mvanhorn/opentac/opentac/cad/web/example-thumbnails/allegro_palm.png

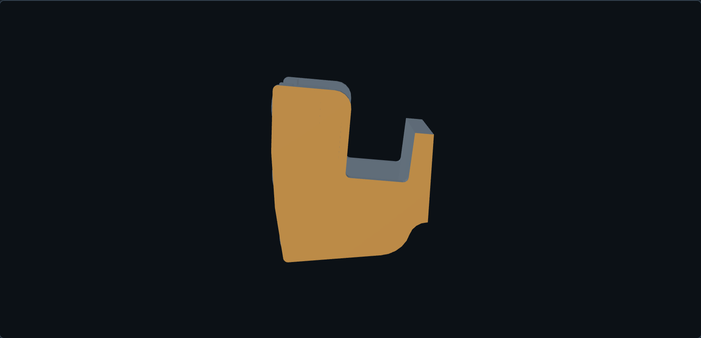
opentac/cad/web/example-thumbnails/allegro_palm.png
