mvanhorn/opentac/opentac/cad/web/example-thumbnails/FINGER_PAD_t30_L.png

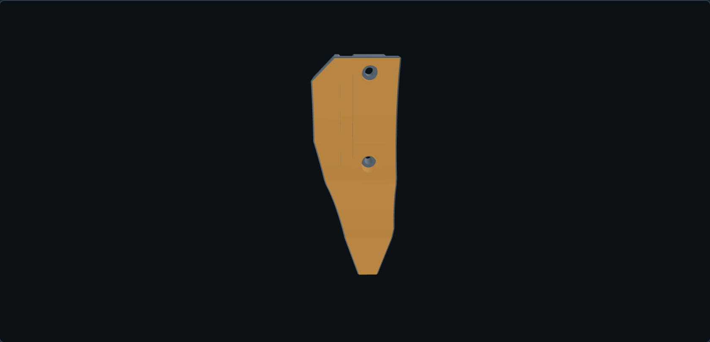
opentac/cad/web/example-thumbnails/FINGER_PAD_t30_L.png
