mvanhorn/opentac/opentac/cad/web/example-thumbnails/franka_fingertip.png

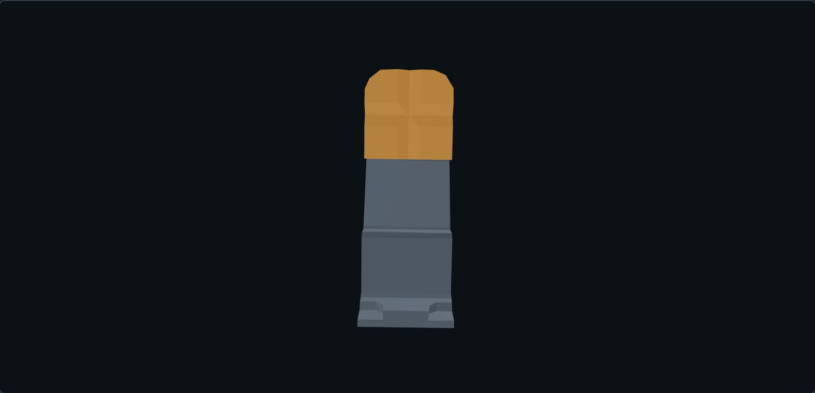
opentac/cad/web/example-thumbnails/franka_fingertip.png
