mvanhorn/opentac/opentac/cad/web/example-thumbnails/leap_hand_fingertip.png

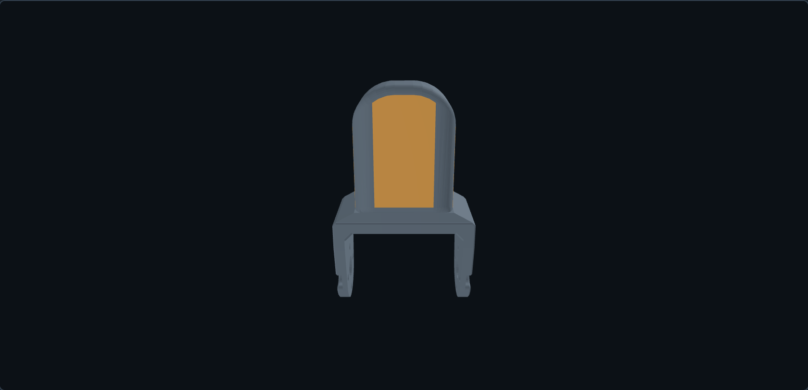
opentac/cad/web/example-thumbnails/leap_hand_fingertip.png
