mvanhorn/opentac/opentac/cad/web/example-thumbnails/so101_fixed_jaw_wrist_roll.png

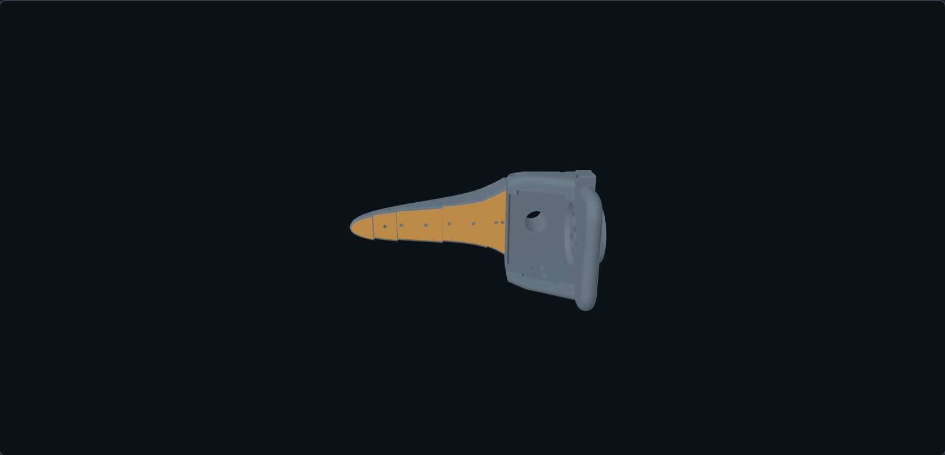
opentac/cad/web/example-thumbnails/so101_fixed_jaw_wrist_roll.png
