mvanhorn/opentac/opentac/cad/web/example-thumbnails/so101_moving_jaw.png

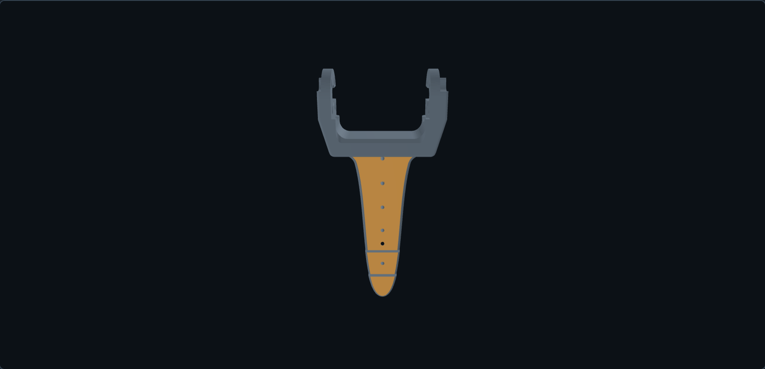
opentac/cad/web/example-thumbnails/so101_moving_jaw.png
