mvanhorn/opentac/opentac/cad/web/example-thumbnails/umi_soft_gripper_finger.png

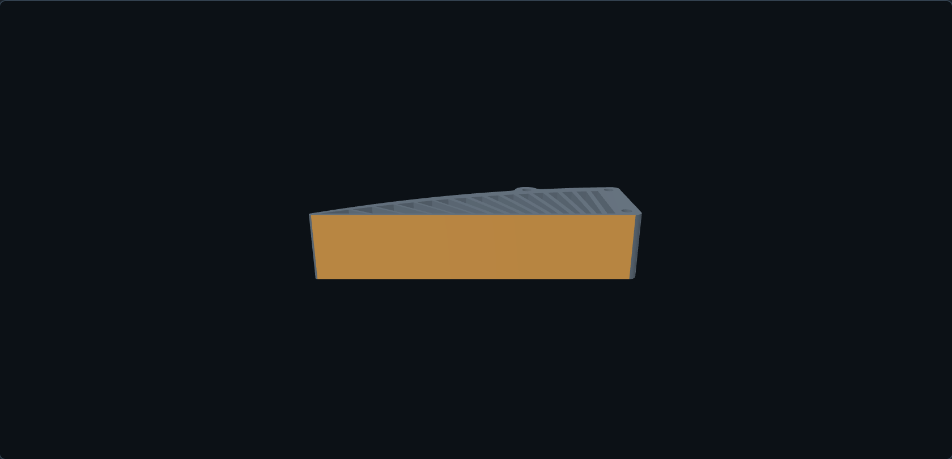
opentac/cad/web/example-thumbnails/umi_soft_gripper_finger.png
