mvanhorn/opentac/hardware/readout_30pin/top/bom.csv

Designator | Footprint | Quantity | Value | LCSC Part # | MPN
C16, C2, C3, C31, C32 | 0201 | 5 | 0.1u | C49062 | CL03A104KP3NNNC
C28, C38, C39 | 0402 | 3 | 10u | C15525 | CL05A106MQ5NUNC
CN1, CN2 | C160390_CONN-SMD_BM04B-SRSS-TB | 2 | BM04B-SRSS-TB(LF)(SN) | C160390 | BM04B-SRSS-TB(LF)(SN)
D1, D3 | C191023_SOD-323_L1_8-W1_3-LS2_5-RD | 2 | 1N5819WS | C191023 | 1N5819WS
IC3 | QFN50P500X500X60-33N-D | 1 | STM32G431KBU6 | C529358 | STM32G431KBU6
IC5 | LSM6DSV16BXTR | 1 | LSM6DSV16BXTR | C5267394 | LSM6DSV16BXTR
J1, J3 | PinHeader_1x07_P1.27mm_Vertical_SMD_Pin1Left | 2 | Conn_01x07_Pin | C55590761 | PZ1.27-1x7PLT-L7.2-R
LED1 | C5349955_LED-SMD_4P-L2_0-W2_0-BR-1 | 1 | XL-2020RGBC-WS2812B | C5349955 | XL-2020RGBC-2812B
R18 | 0201 | 1 | 100k | C106224 | RC0201FR-07100KL
R19, R20 | 0201 | 2 | 4.7k | C138135 | RC0201FR-074K7L
R4 | 0201 | 1 | 10k | C106225 | RC0201FR-0710KL
S4 | SW_TS-1088-AR02016 | 1 | TS-1088-AR02016 | C720477 | TS-1088-AR02016
U1 | SOT-23-5 | 1 | TLV75533PDBV | C404027 | TLV75533PDBVR
USB2 | C2681556_MICRO-USB-SMD_MICRO-QTZB5_0 | 1 | MICRO QTZB5.0 | C2681556 | MICRO QTZB5.0
