mvanhorn/opentac/hardware/readout_30pin/bottom/bom.csv

Designator | Footprint | Quantity | Value | LCSC Part # | MPN
C10, C12, C14, C15, C9 | 0402 | 5 | 0.1u | C1525 | CL05B104KO5NNNC
C34, C35 | 0402 | 2 | 1u | C52923 | CL05A105KA5NQNC
C36 | 0402 | 1 | 10u | C15525 | CL05A106MQ5NUNC
IC1 | SOT65P280X110-8N | 1 | TLV9362IDDFR | C5119287 | TLV9362IDDFR
IC2 | SOP65P638X110-28N | 1 | ADG706BRUZ | C579088 | ADG706BRUZ
IC8, IC9 | NVT2006BQ115 | 2 | 74HC595BQ | C730243 | 74HC595BQ
J2, J3 | PinSocket_1x07_P1.27mm_Vertical_SMD_Pin1Right | 2 | Conn_01x07_Pin | C55218864 | PM1.27-1x7PLT-H4.3-R
J4 | CON_5051103091_MOL | 1 | Conn_01x30_Pin | C588008 | 5051103091
R5, R6, R7 | 0402 | 3 | 1k | C11702 | 0402WGF1001TCE
U7 | SOT-23-6 | 1 | LM2776 | C69527 | LM2776DBVR
