mvanhorn/opentac/hardware/readout_60pin/production/stm-i2c-60-switch_bom.csv

Designator | Footprint | Quantity | Value | LCSC Part #
C1, C10, C13, C14, C15, C17, C60, C9 | 0402 | 8 | 0.1u | C1525
C16, C2, C3, C31, C32 | 0201 | 5 | 0.1u | C49062
C28, C36, C38, C39 | 0402 | 4 | 10u | C15525
C34, C35 | 0402 | 2 | 1u | C52923
C52 | 0402 | 1 | 47p | C1567
C54 | 0402 | 1 | 100p | C1546
C55 | 0402 | 1 | 470p | C106259
C57 | 0402 | 1 | 1.8n | C385028
C59 | 0402 | 1 | 6.8n | C1518206
CN1, CN2 | C160390_CONN-SMD_BM04B-SRSS-TB | 2 | BM04B-SRSS-TB(LF)(SN) | C160390
D1, D3 | C191023_SOD-323_L1_8-W1_3-LS2_5-RD | 2 | 1N5819WS | C191023
IC1 | SOT65P280X110-8N | 1 | TLV9362IDDFR | C5119287
IC11, IC12, IC8, IC9 | NVT2006BQ115 | 4 | 74HC595BQ | C730243
IC3 | QFN50P500X500X60-33N-D | 1 | STM32G431KBU6 | C529358
IC4 | QFP50P900X900X120-48N | 1 | ADG732BSUZ | C114845
IC5 | LSM6DSV16BXTR | 1 | LSM6DSV16BXTR | C5267394
J4 | C493444_FPC-SMD_5051106091 | 1 | 5051106091 | C493444
LED1 | C5349955_LED-SMD_4P-L2_0-W2_0-BR-1 | 1 | XL-2020RGBC-WS2812B | C5349955
R18 | 0201 | 1 | 100k | C106224
R19, R20 | 0201 | 2 | 4.7k | C138135
R21 | 0402 | 1 | 10k | C25744
R23 | 0402 | 1 | 4.7k | C25900
R24 | 0402 | 1 | 1.1k | C25860
R26 | 0402 | 1 | 270 | C25099
R28 | 0402 | 1 | 68 | C25131
R4 | 0201 | 1 | 10k | C106225
R6, R7 | 0402 | 2 | 1k | C11702
S4 | SW_TS-1088-AR02016 | 1 | TS-1088-AR02016 | C720477
U1 | SOT-23-5 | 1 | TLV75533PDBV | C404027
U10 | C2673377_TQFN-28_L4_0-W4_0-P0_40-BL-EP | 1 | MAX14662ETI+T | C2673377
U7 | SOT-23-6 | 1 | LM2776 | C69527
USB2 | C404969_MICRO-USB-SMD_MICROXNJ_1 | 1 | MicroXNJ | C404969
