mvanhorn/opentac/examples/stl/end_effectors/agilex_piper/gripper_base.stl

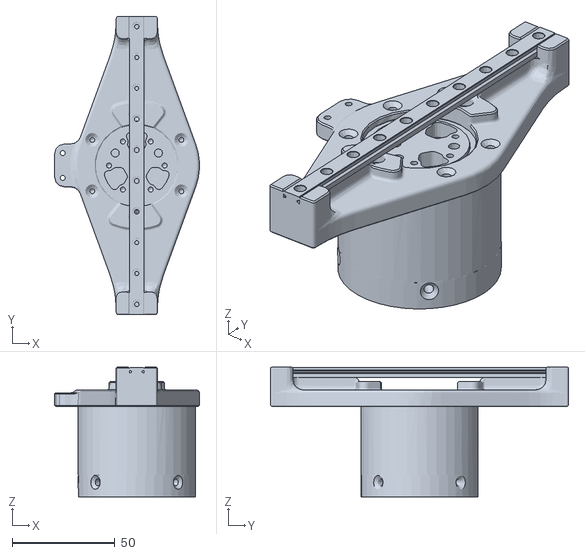
[picture p9: CAD file, 2026-10-15]
examples/stl/end_effectors/agilex_piper/gripper_base.stl
70.5 x 145.0 x 63.0
