mvanhorn/opentac/examples/stl/end_effectors/allegro/thumb_fingertip.stl

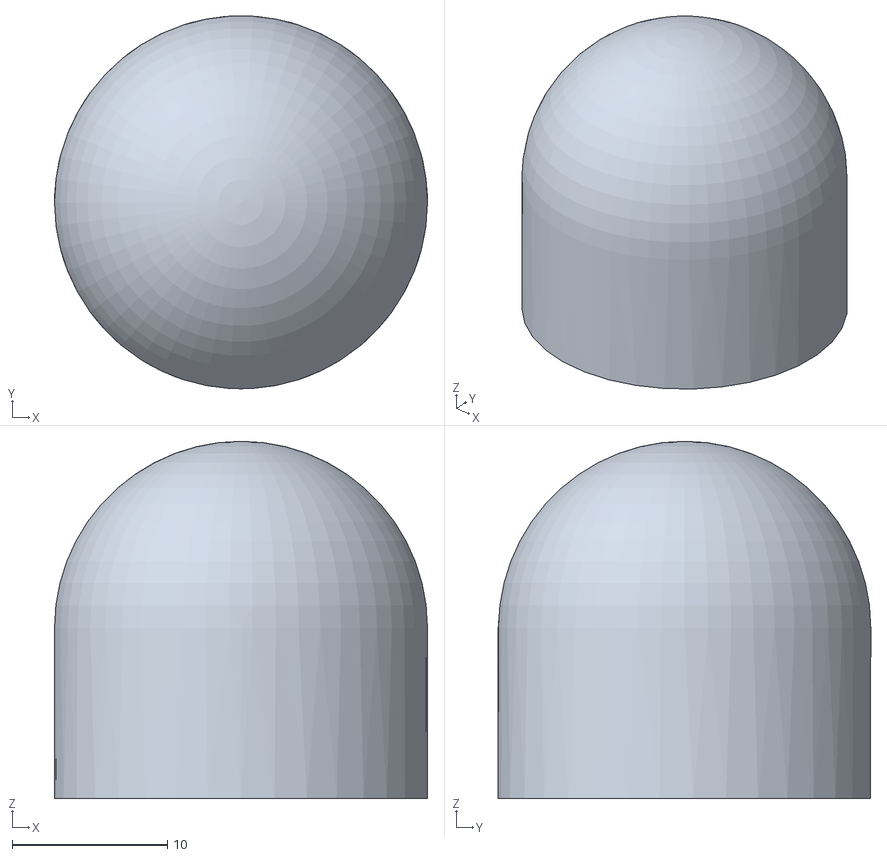
[picture p10: CAD file, 2026-10-15]
examples/stl/end_effectors/allegro/thumb_fingertip.stl
24.0 x 24.0 x 23.0
