mvanhorn/opentac/examples/stl/end_effectors/aloha_vx300s/gripper_finger.stl

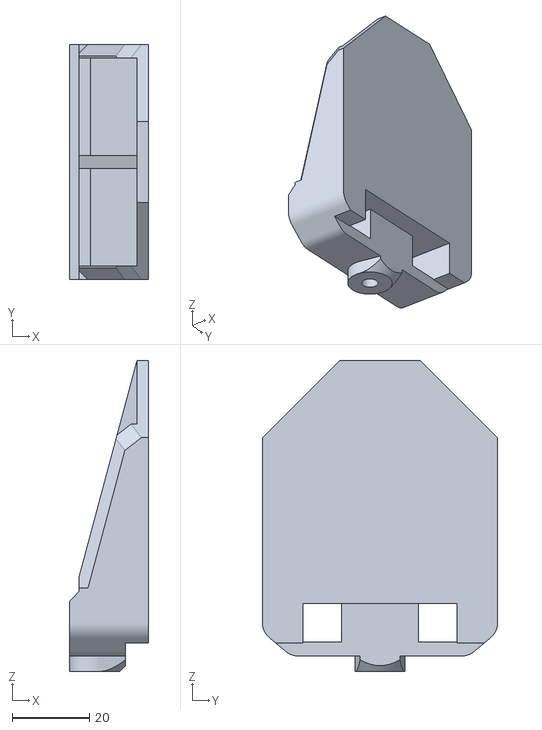
[picture p11: CAD file, 2026-10-15]
examples/stl/end_effectors/aloha_vx300s/gripper_finger.stl
20.5 x 61.0 x 80.6
