mvanhorn/opentac/examples/stl/end_effectors/dclaw/fingertip_4.stl

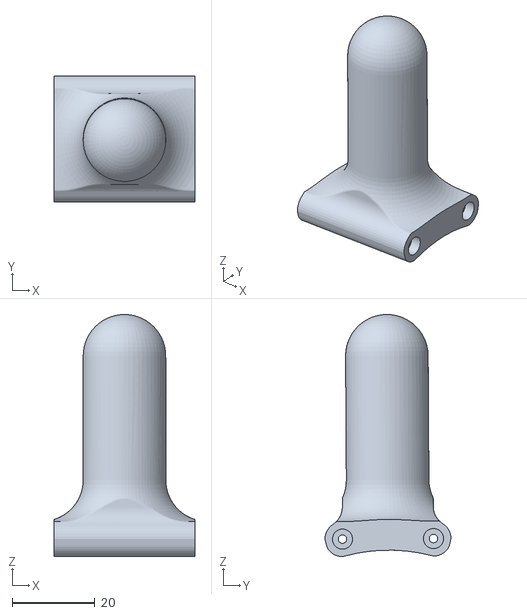
[picture p12: CAD file, 2026-10-15]
examples/stl/end_effectors/dclaw/fingertip_4.stl
34.0 x 30.5 x 58.5
