mvanhorn/opentac/examples/stl/end_effectors/franka/arm_link5.stl

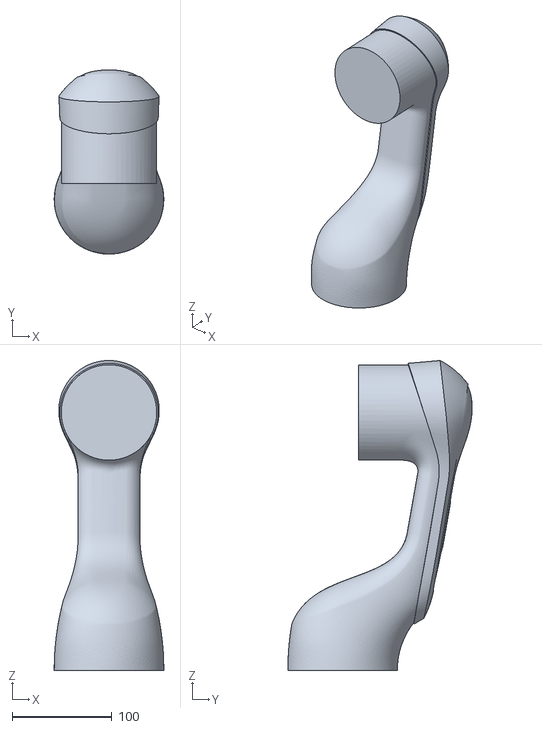
[picture p13: CAD file, 2026-10-15]
examples/stl/end_effectors/franka/arm_link5.stl
110.0 x 184.9 x 311.2
