mvanhorn/opentac/examples/stl/end_effectors/inspire_hand/palm.stl

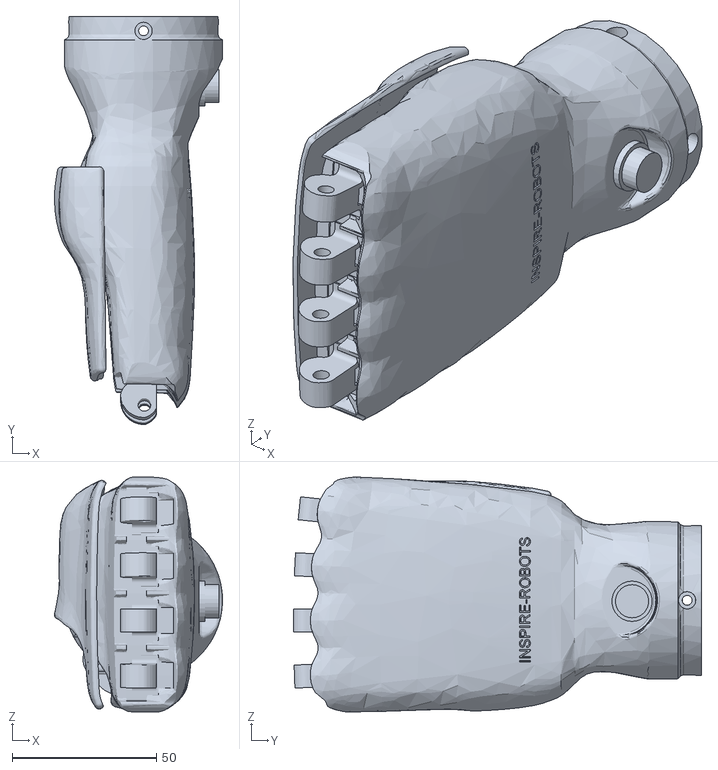
[picture p14: CAD file, 2026-10-15]
examples/stl/end_effectors/inspire_hand/palm.stl
58.3 x 141.5 x 81.5
