mvanhorn/opentac/examples/stl/end_effectors/leap_hand/palm.stl

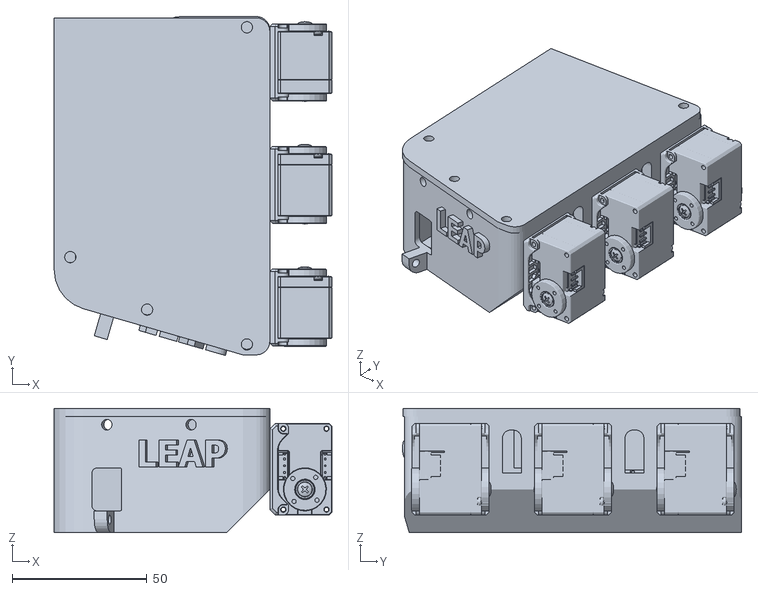
[picture p15: CAD file, 2026-10-15]
examples/stl/end_effectors/leap_hand/palm.stl
103.0 x 125.7 x 46.0
