mvanhorn/opentac/examples/stl/end_effectors/onrobot_rg2/inner_finger.stl

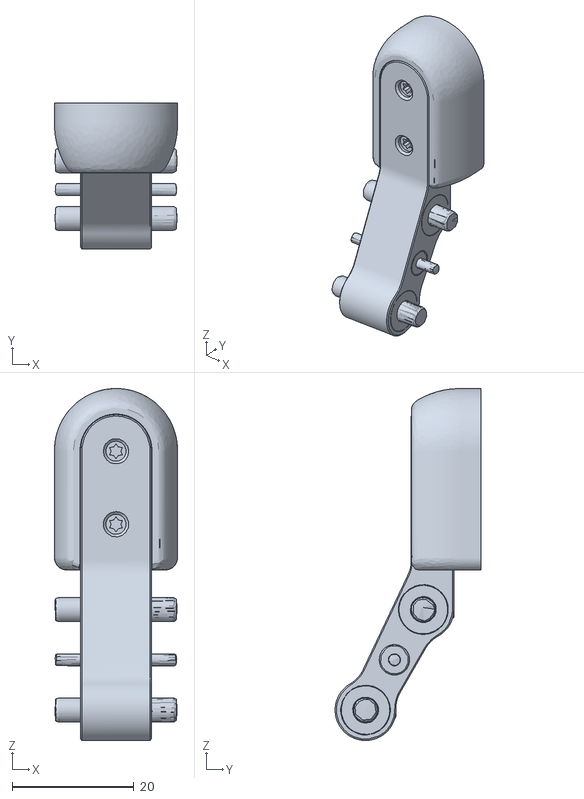
[picture p16: CAD file, 2026-10-15]
examples/stl/end_effectors/onrobot_rg2/inner_finger.stl
20.2 x 23.9 x 57.8
