mvanhorn/opentac/examples/stl/end_effectors/onrobot_vg10/suction_cups.stl

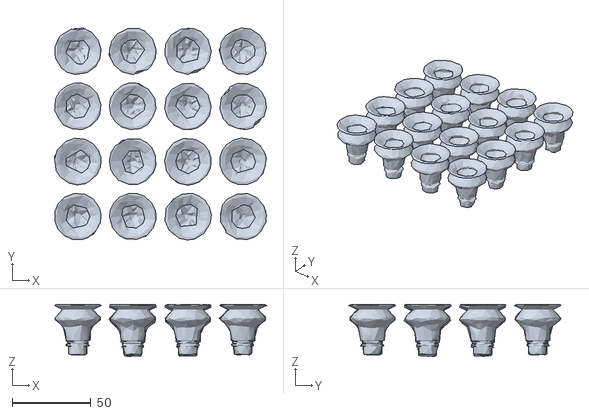
[picture p17: CAD file, 2026-10-15]
examples/stl/end_effectors/onrobot_vg10/suction_cups.stl
134.7 x 134.7 x 33.1
