mvanhorn/opentac/examples/stl/end_effectors/orca_hand/palm.stl

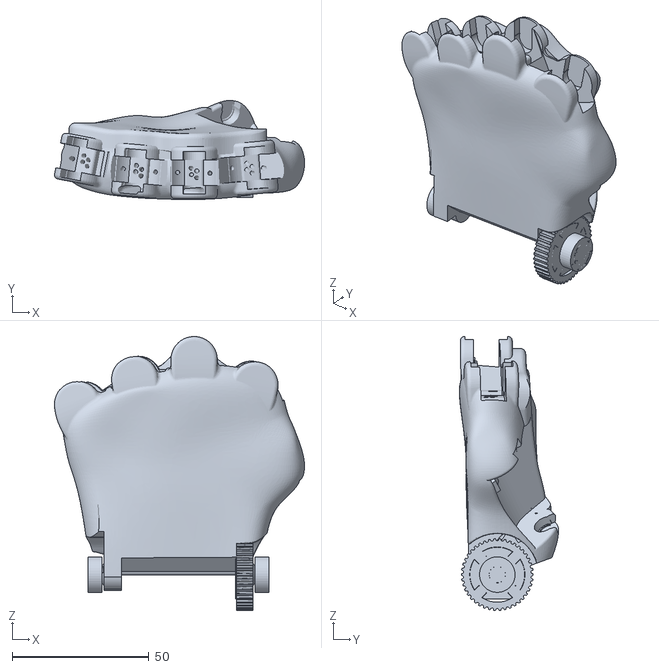
[picture p18: CAD file, 2026-10-15]
examples/stl/end_effectors/orca_hand/palm.stl
91.4 x 36.3 x 100.1
