mvanhorn/opentac/examples/stl/end_effectors/robotiq_2f140/inner_finger.stl

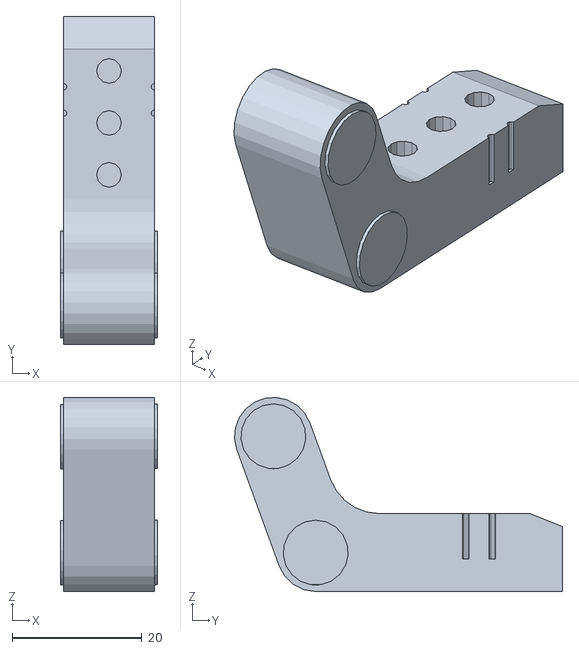
[picture p19: CAD file, 2026-10-15]
examples/stl/end_effectors/robotiq_2f140/inner_finger.stl
15.0 x 50.5 x 29.9
