mvanhorn/opentac/examples/stl/end_effectors/schunk_sdh/finger.stl

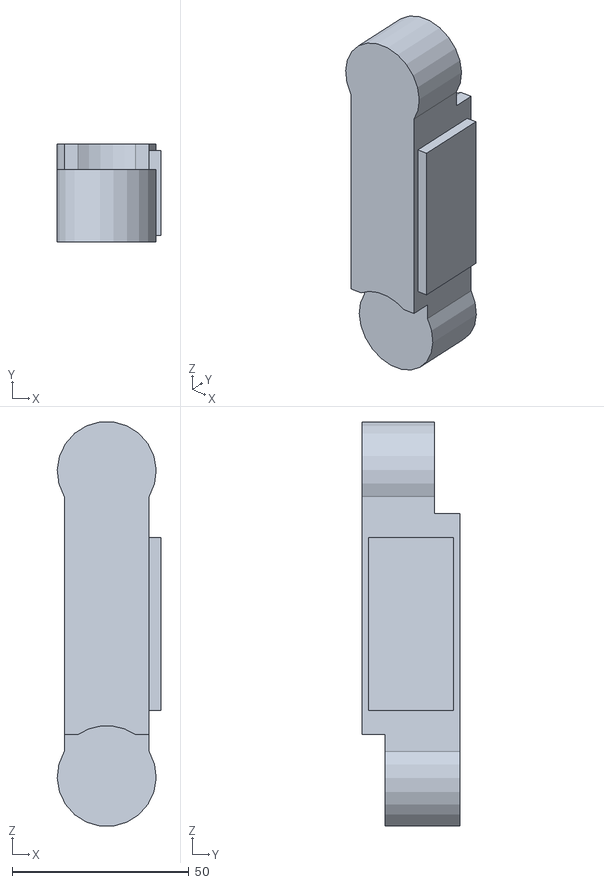
[picture p20: CAD file, 2026-10-15]
examples/stl/end_effectors/schunk_sdh/finger.stl
29.3 x 27.8 x 114.2
