mvanhorn/opentac/examples/stl/end_effectors/so101/fixed_jaw_wrist_roll.stl

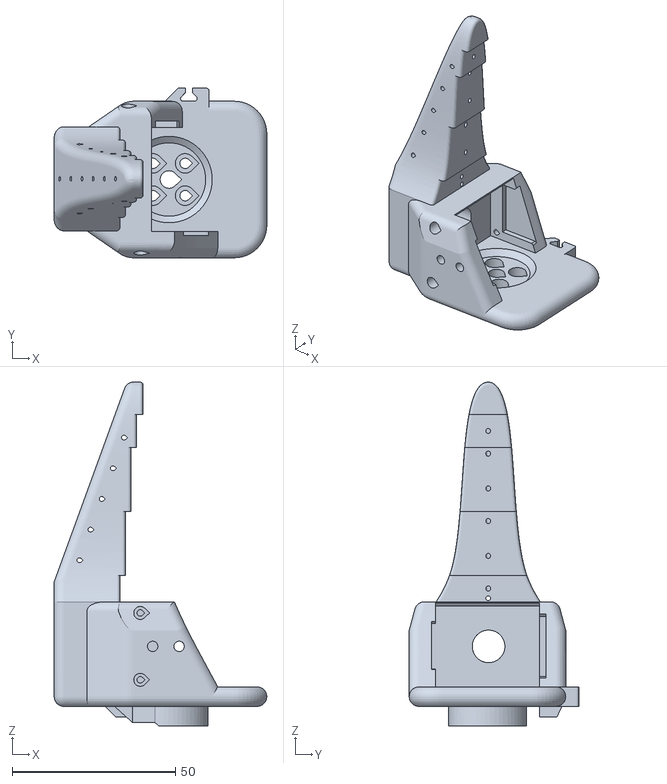
[picture p21: CAD file, 2026-10-15]
examples/stl/end_effectors/so101/fixed_jaw_wrist_roll.stl
65.2 x 52.0 x 105.4
