mvanhorn/opentac/examples/stl/end_effectors/umi/jaw_right.stl

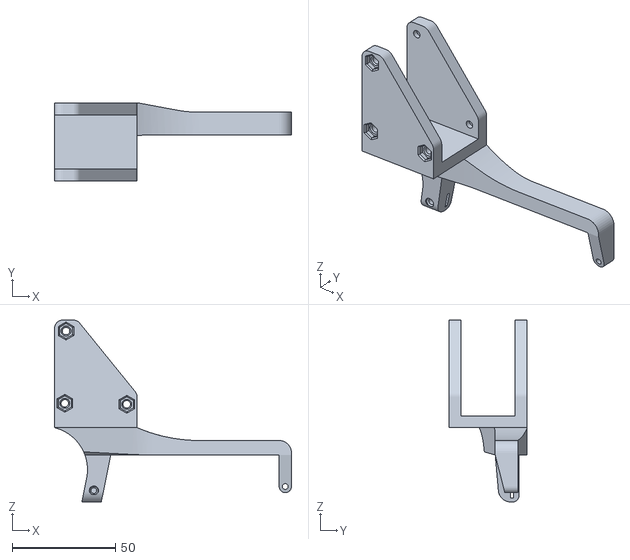
[picture p22: CAD file, 2026-10-15]
examples/stl/end_effectors/umi/jaw_right.stl
114.8 x 38.0 x 88.1
