mvanhorn/opentac/examples/stl/end_effectors/unitree_b2/foot.stl

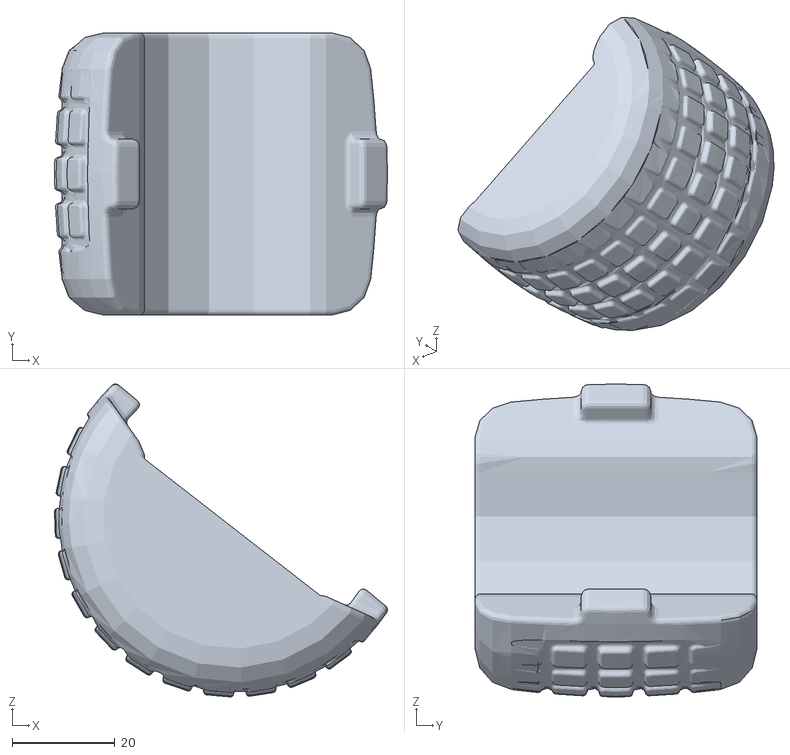
[picture p23: CAD file, 2026-10-15]
examples/stl/end_effectors/unitree_b2/foot.stl
64.9 x 55.0 x 61.0
