mvanhorn/opentac/examples/stl/end_effectors/unitree_dex3/palm.stl

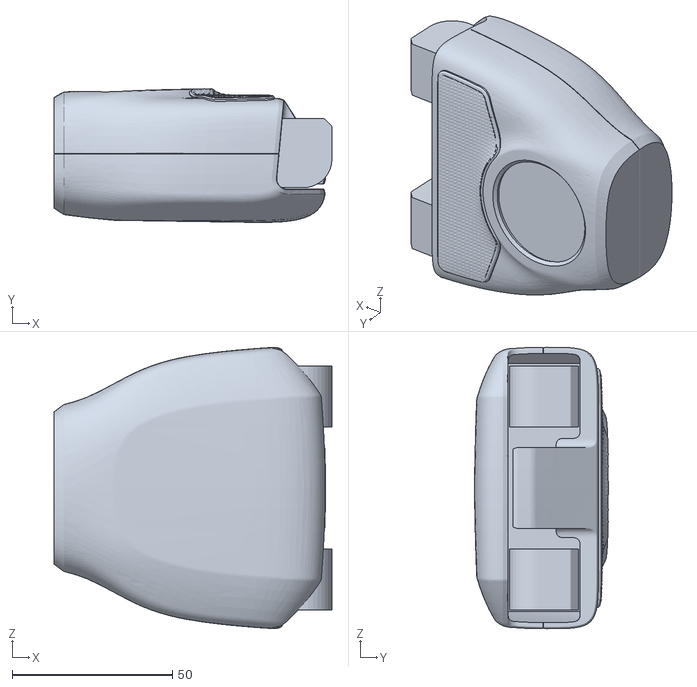
[picture p24: CAD file, 2026-10-15]
examples/stl/end_effectors/unitree_dex3/palm.stl
86.7 x 41.7 x 87.8
