mvanhorn/opentac/examples/stl/end_effectors/unitree_go2/calf.stl

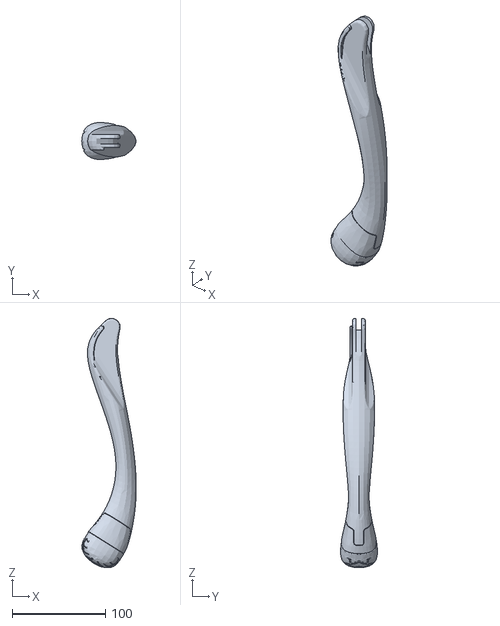
[picture p25: CAD file, 2026-10-15]
examples/stl/end_effectors/unitree_go2/calf.stl
58.4 x 39.6 x 266.7
