mvanhorn/opentac/examples/stl/end_effectors/xarm_gripper/lite_finger.stl

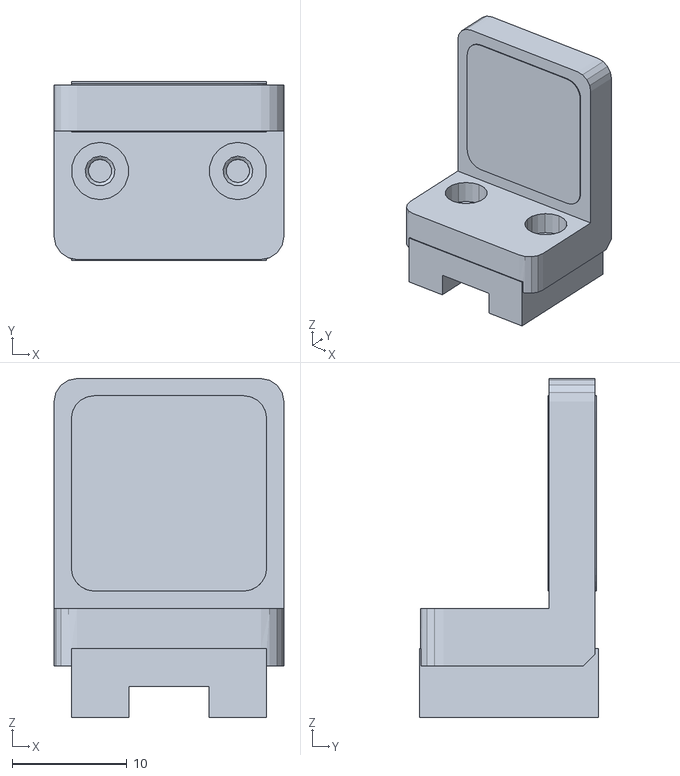
[picture p26: CAD file, 2026-10-15]
examples/stl/end_effectors/xarm_gripper/lite_finger.stl
20.0 x 15.6 x 29.5
