mvanhorn/opentac/examples/stl/end_effectors/yale_openhand/model_o_proximal.stl

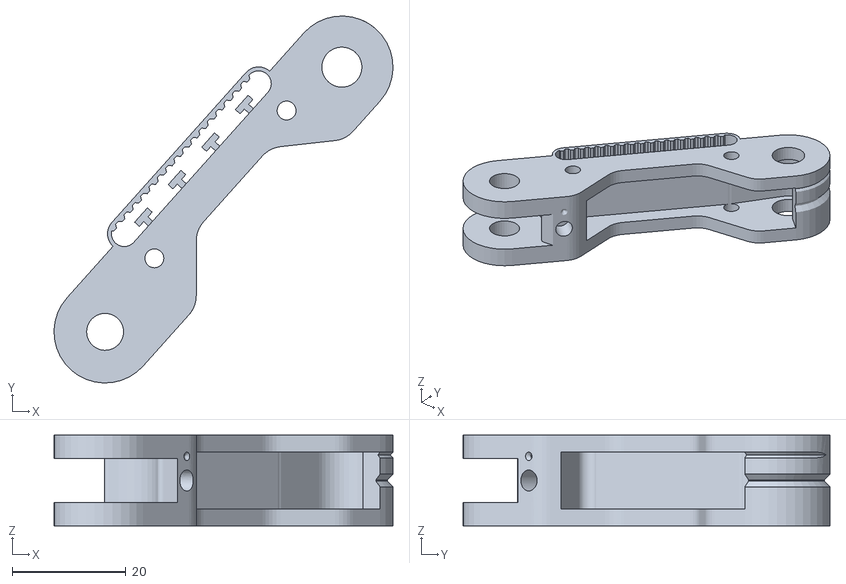
[picture p27: CAD file, 2026-10-15]
examples/stl/end_effectors/yale_openhand/model_o_proximal.stl
59.7 x 64.6 x 16.0
