mvanhorn/opentac/examples/stl/FINGER PAD_t30_L.stl

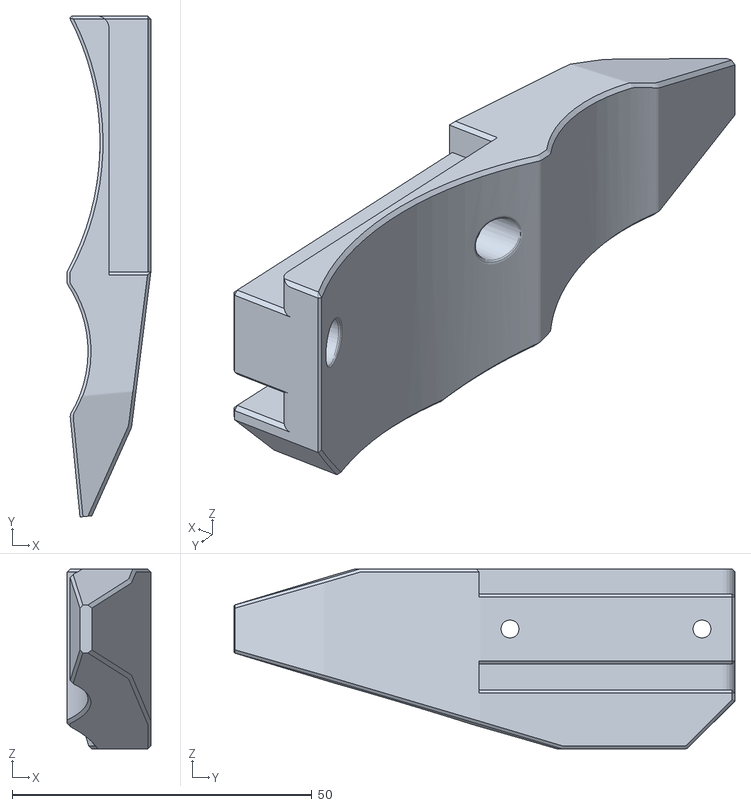
[picture p28: CAD file, 2026-10-15]
examples/stl/FINGER PAD_t30_L.stl
14.0 x 83.5 x 30.0
