mvanhorn/opentac/opentac/cad/web/example-meshes/inspire_hand_thumb_distal.stl

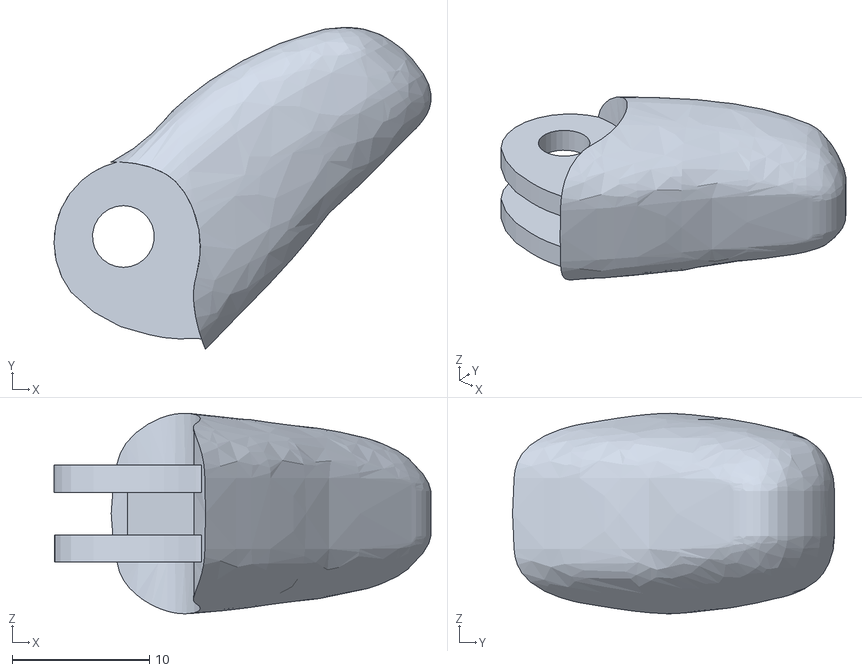
[picture p29: CAD file, 2026-10-15]
opentac/cad/web/example-meshes/inspire_hand_thumb_distal.stl
27.5 x 23.5 x 14.6
