mvanhorn/opentac/examples/stl/end_effectors/agilex_piper/jaw_link7.stl

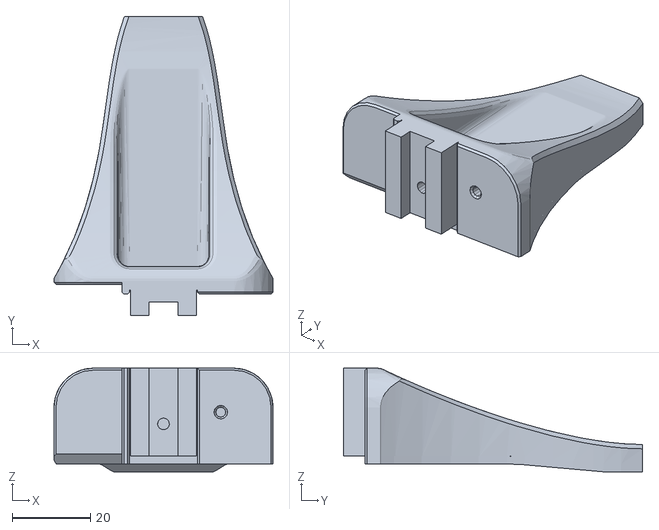
[picture p30: CAD file, 2026-10-15]
examples/stl/end_effectors/agilex_piper/jaw_link7.stl
56.0 x 76.5 x 26.5
