mvanhorn/opentac/examples/stl/end_effectors/dclaw/fingertip.stl

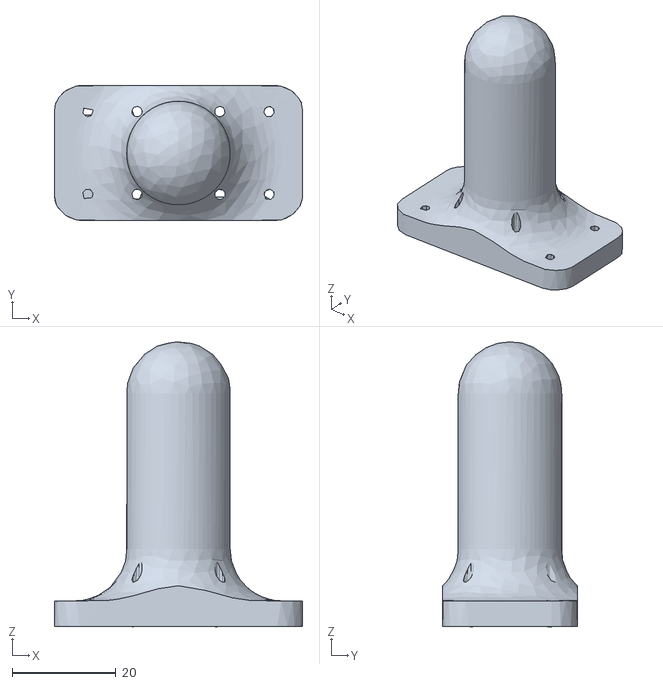
[picture p31: CAD file, 2026-10-15]
examples/stl/end_effectors/dclaw/fingertip.stl
48.0 x 26.0 x 55.1
