mvanhorn/opentac/examples/stl/end_effectors/franka/fingertip.stl

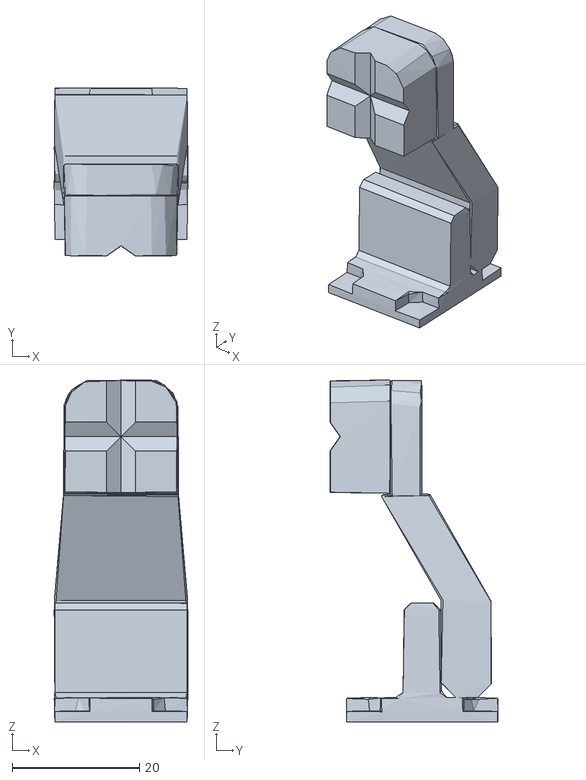
[picture p32: CAD file, 2026-10-15]
examples/stl/end_effectors/franka/fingertip.stl
21.0 x 26.4 x 53.8
