mvanhorn/opentac/examples/stl/end_effectors/inspire_hand/index_fingertip.stl

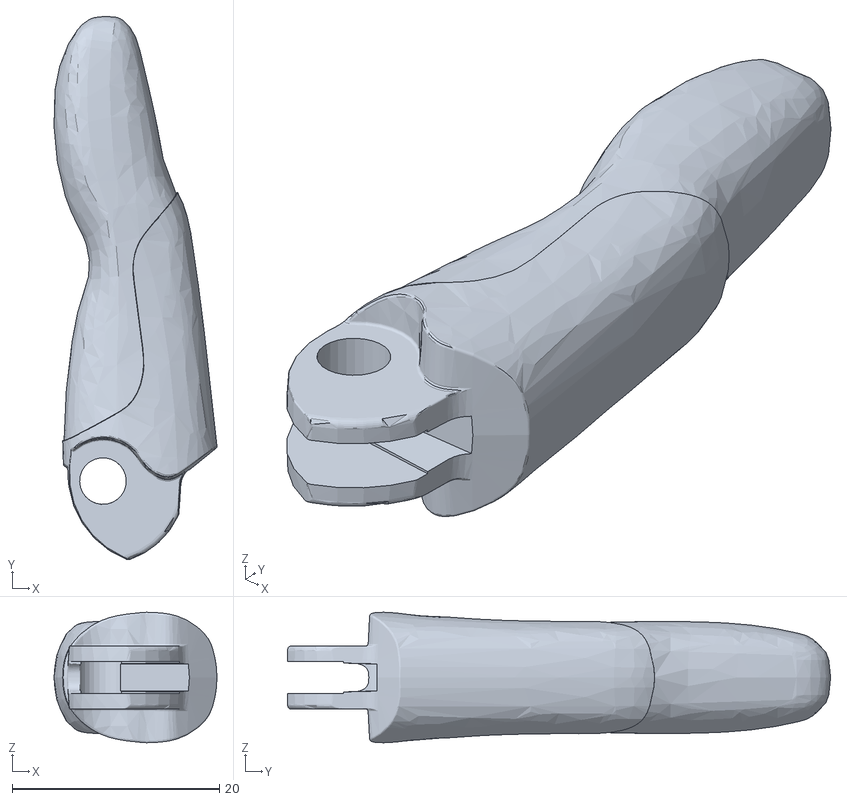
[picture p33: CAD file, 2026-10-15]
examples/stl/end_effectors/inspire_hand/index_fingertip.stl
15.7 x 52.5 x 12.6
