mvanhorn/opentac/examples/stl/end_effectors/leap_hand/thumb_fingertip.stl

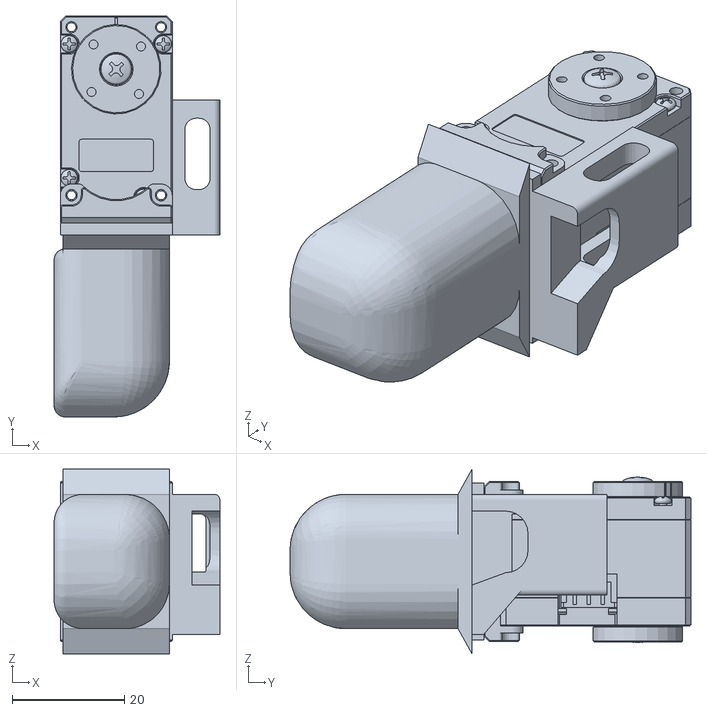
[picture p34: CAD file, 2026-10-15]
examples/stl/end_effectors/leap_hand/thumb_fingertip.stl
29.6 x 71.6 x 33.0
