mvanhorn/opentac/examples/stl/end_effectors/onrobot_vg10/base.stl

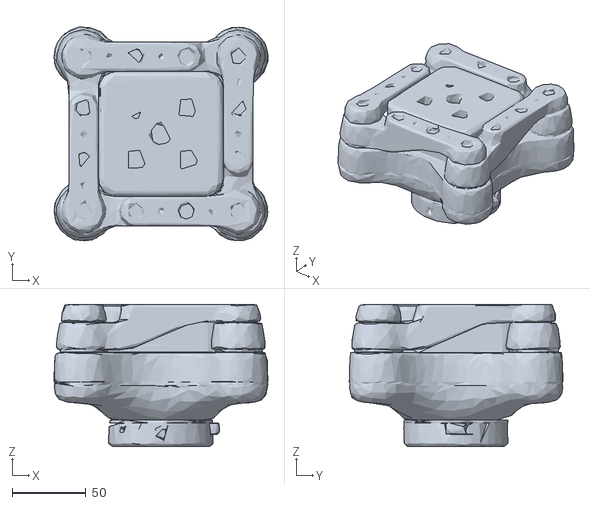
[picture p35: CAD file, 2026-10-15]
examples/stl/end_effectors/onrobot_vg10/base.stl
145.4 x 145.2 x 96.7
