mvanhorn/opentac/examples/stl/end_effectors/orca_hand/fingertip.stl

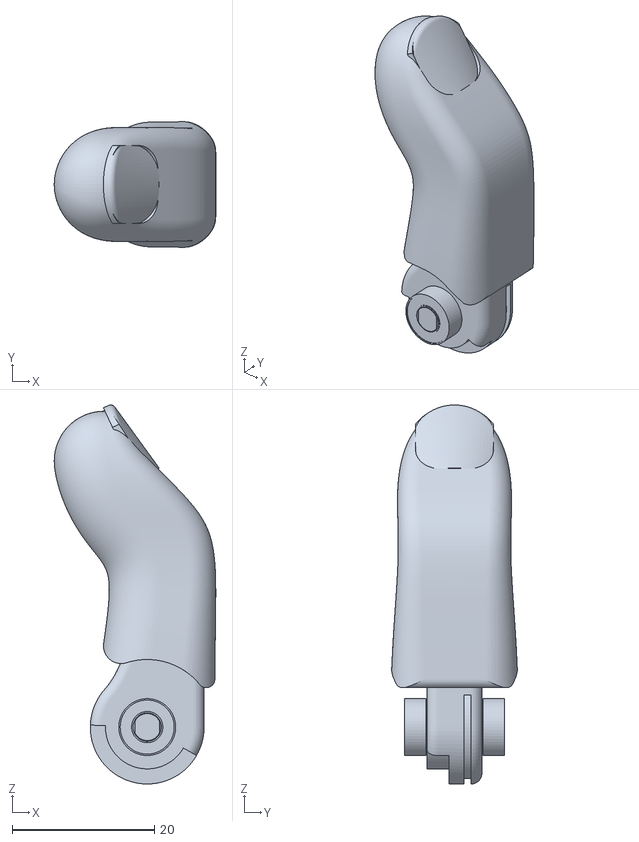
[picture p36: CAD file, 2026-10-15]
examples/stl/end_effectors/orca_hand/fingertip.stl
22.7 x 17.7 x 53.3
