mvanhorn/opentac/examples/stl/end_effectors/schunk_sdh/finger_tip.stl

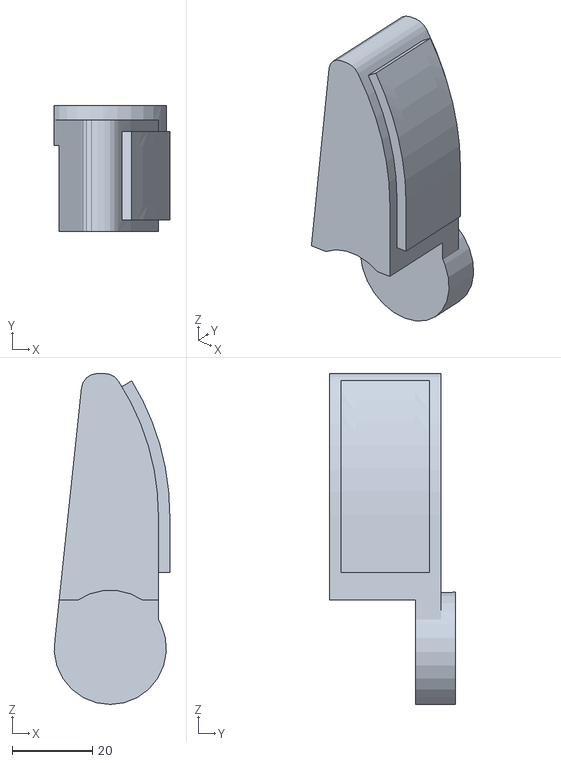
[picture p37: CAD file, 2026-10-15]
examples/stl/end_effectors/schunk_sdh/finger_tip.stl
28.8 x 31.3 x 82.5
