mvanhorn/opentac/examples/stl/end_effectors/so101/moving_jaw.stl

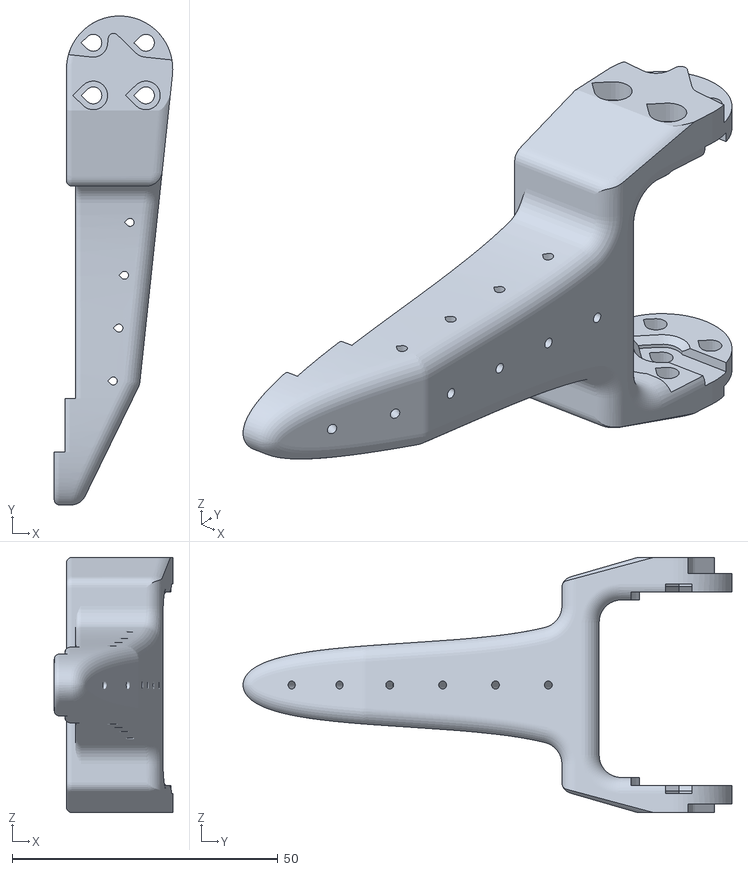
[picture p38: CAD file, 2026-10-15]
examples/stl/end_effectors/so101/moving_jaw.stl
22.3 x 92.0 x 48.0
