mvanhorn/opentac/examples/stl/end_effectors/unitree_dex3/thumb_distal.stl

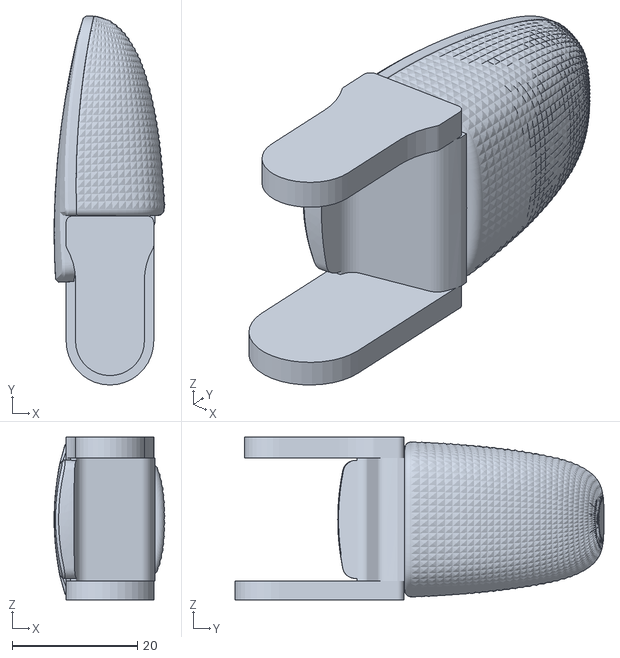
[picture p39: CAD file, 2026-10-15]
examples/stl/end_effectors/unitree_dex3/thumb_distal.stl
17.7 x 59.0 x 26.0
