mvanhorn/opentac/examples/stl/end_effectors/unitree_go2/foot.stl

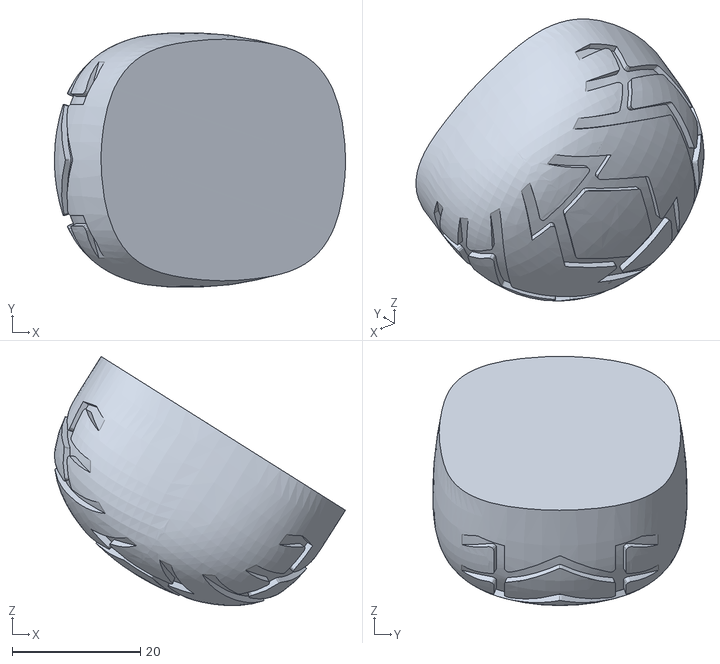
[picture p40: CAD file, 2026-10-15]
examples/stl/end_effectors/unitree_go2/foot.stl
45.3 x 39.6 x 38.8
