mvanhorn/opentac/examples/stl/end_effectors/xarm_gripper/bio_left_finger.stl

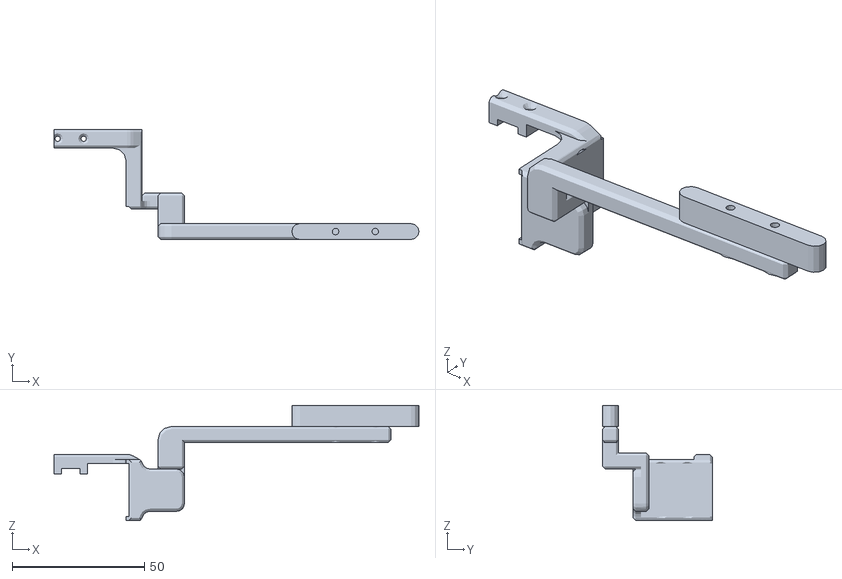
[picture p41: CAD file, 2026-10-15]
examples/stl/end_effectors/xarm_gripper/bio_left_finger.stl
137.7 x 41.5 x 43.5
