mvanhorn/opentac/examples/stl/end_effectors/yale_openhand/t42_distal.stl

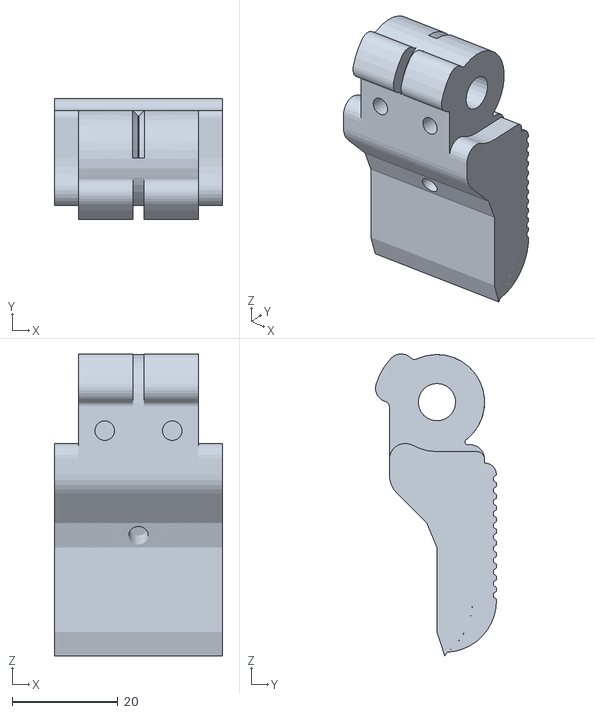
[picture p42: CAD file, 2026-10-15]
examples/stl/end_effectors/yale_openhand/t42_distal.stl
31.8 x 22.9 x 57.1
