mvanhorn/opentac/opentac/cad/web/example-meshes/allegro_palm.stl

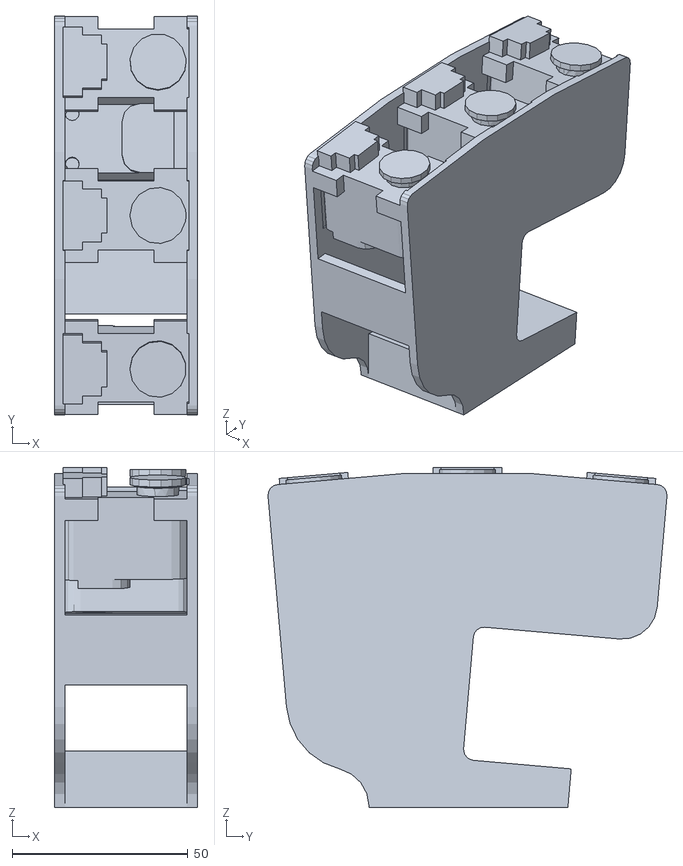
[picture p43: CAD file, 2026-10-15]
opentac/cad/web/example-meshes/allegro_palm.stl
40.8 x 113.5 x 96.7
