mvanhorn/opentac/examples/stl/end_effectors/franka/hand_body.stl

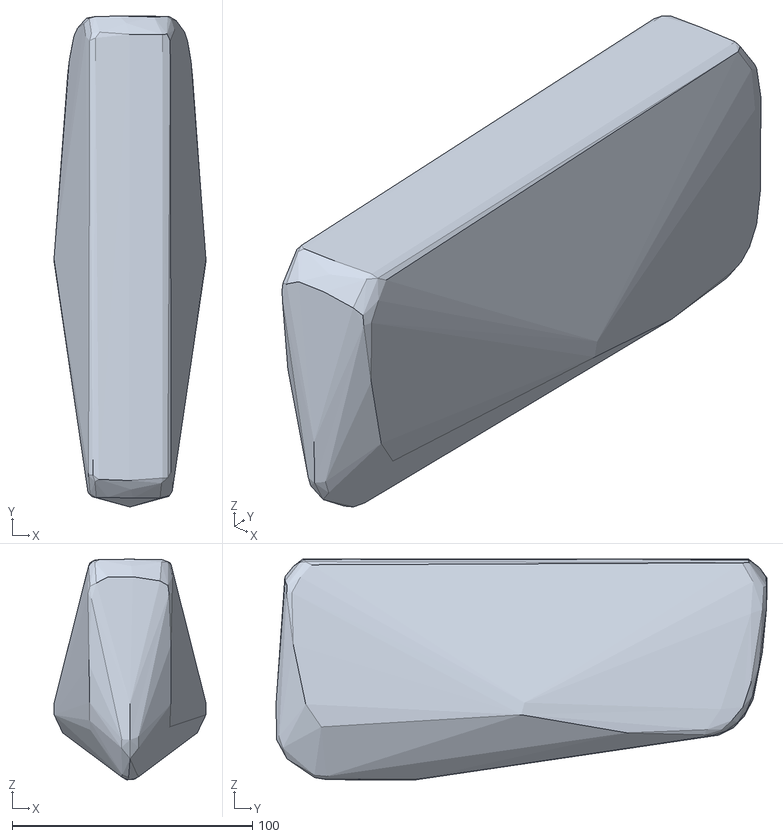
[picture p44: CAD file, 2026-10-15]
examples/stl/end_effectors/franka/hand_body.stl
63.3 x 204.4 x 91.9
