mvanhorn/opentac/examples/stl/end_effectors/leap_hand/mcp_joint.stl

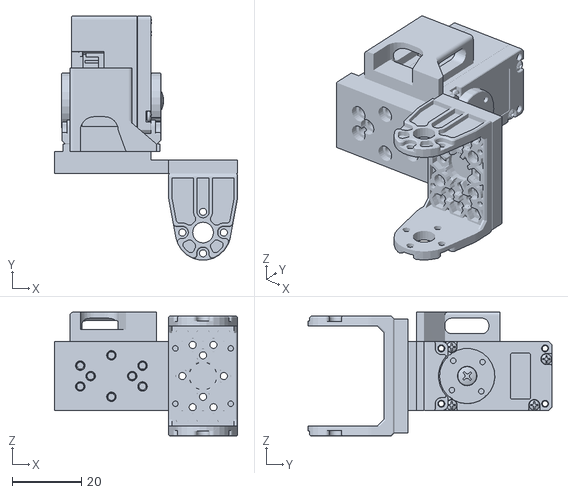
[picture p45: CAD file, 2026-10-15]
examples/stl/end_effectors/leap_hand/mcp_joint.stl
53.0 x 70.5 x 35.8
