mvanhorn/opentac/examples/stl/end_effectors/schunk_sdh/palm.stl

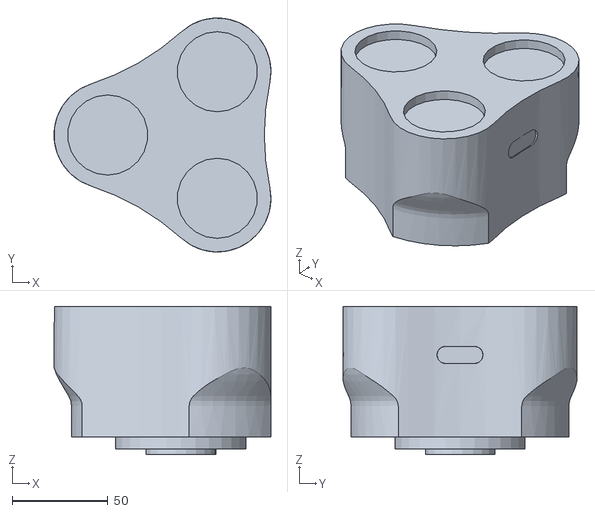
[picture p46: CAD file, 2026-10-15]
examples/stl/end_effectors/schunk_sdh/palm.stl
113.2 x 122.0 x 77.2
