mvanhorn/opentac/examples/stl/end_effectors/xarm_gripper/right_finger.stl

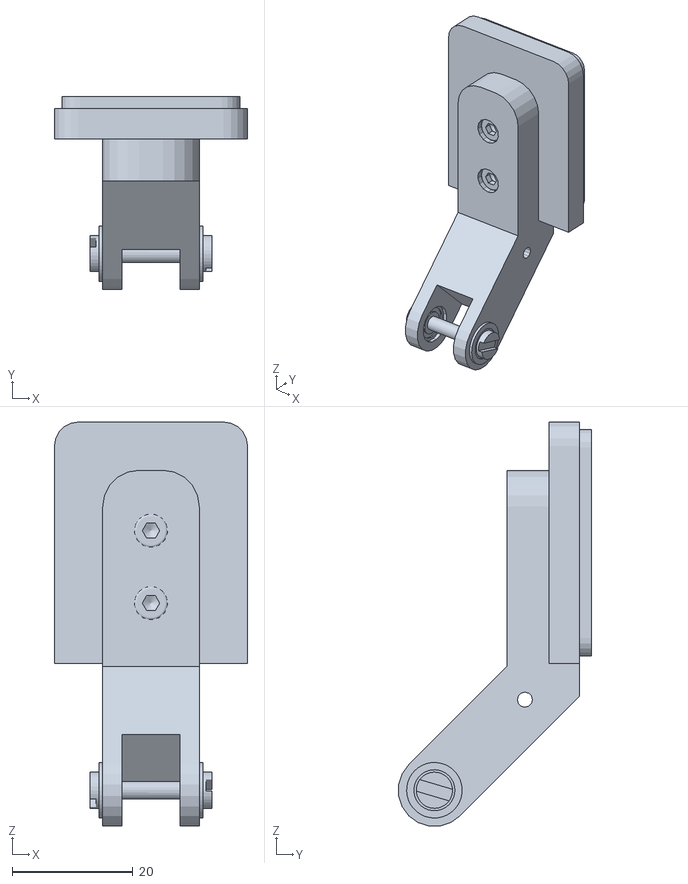
[picture p47: CAD file, 2026-10-15]
examples/stl/end_effectors/xarm_gripper/right_finger.stl
32.0 x 31.9 x 66.9
