mvanhorn/opentac/examples/stl/end_effectors/franka/arm_link4.stl

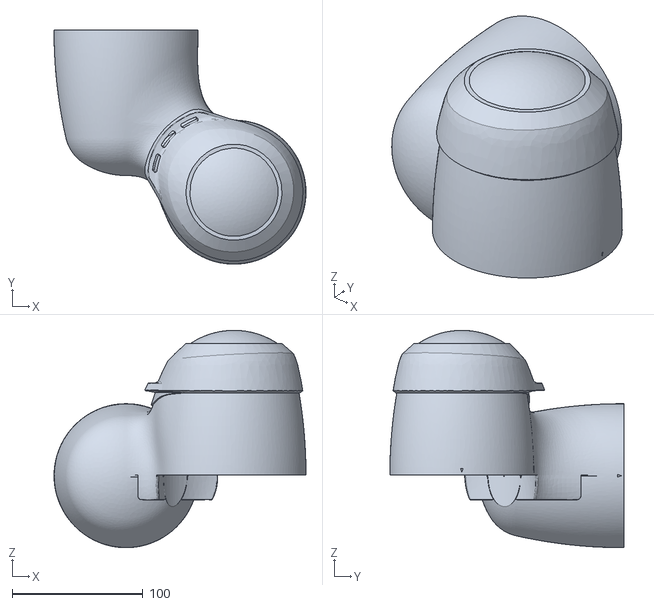
[picture p48: CAD file, 2026-10-15]
examples/stl/end_effectors/franka/arm_link4.stl
192.5 x 179.0 x 166.1
