mvanhorn/opentac/examples/stl/end_effectors/leap_hand/pip.stl

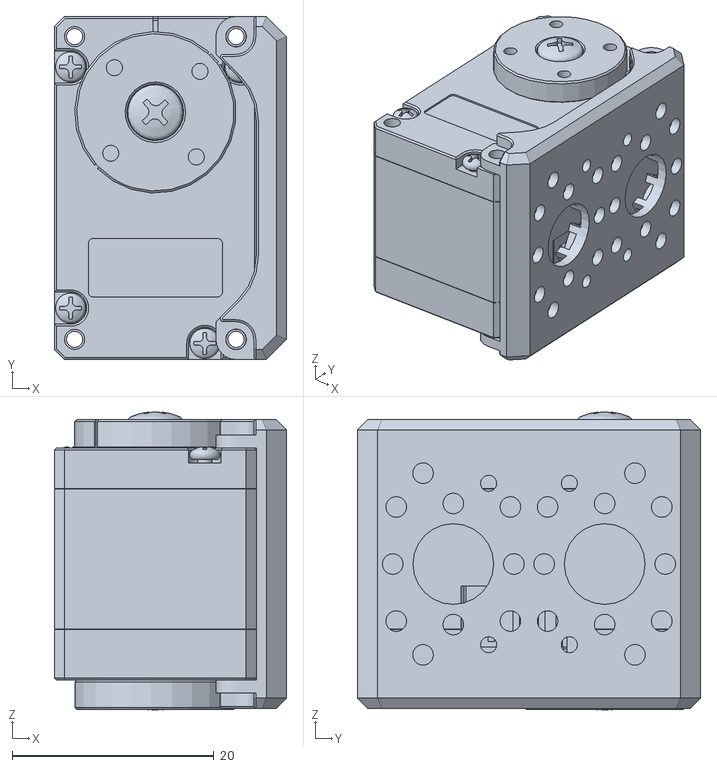
[picture p49: CAD file, 2026-10-15]
examples/stl/end_effectors/leap_hand/pip.stl
23.0 x 34.0 x 29.5
