mvanhorn/opentac/examples/stl/end_effectors/leap_hand/fingertip.stl

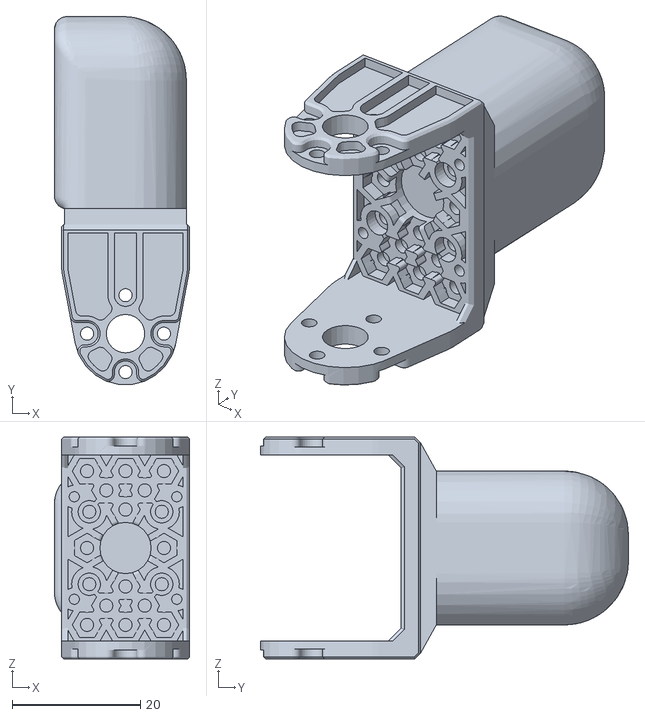
[picture p50: CAD file, 2026-10-15]
examples/stl/end_effectors/leap_hand/fingertip.stl
21.1 x 57.4 x 34.6
