mvanhorn/opentac/opentac/cad/web/example-meshes/leap_hand_dip.stl

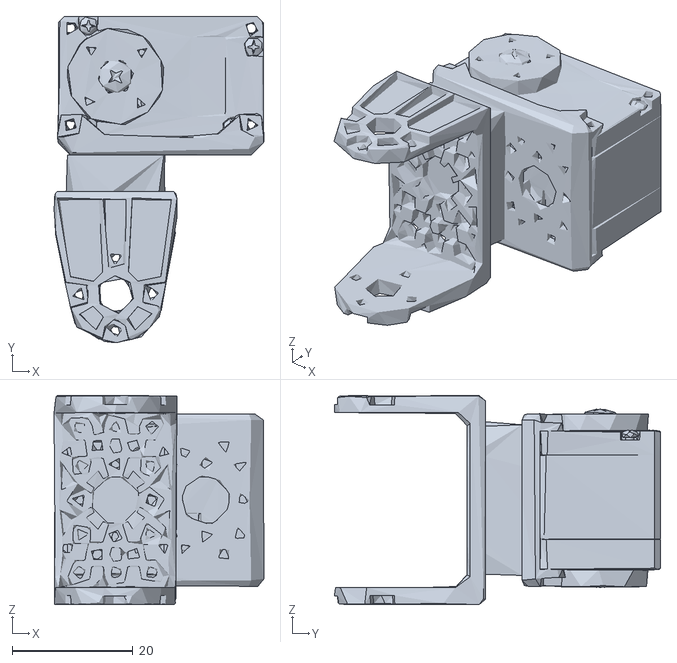
[picture p51: CAD file, 2026-10-15]
opentac/cad/web/example-meshes/leap_hand_dip.stl
34.8 x 54.2 x 34.7
