mvanhorn/opentac/examples/stl/end_effectors/leap_hand/dip.stl

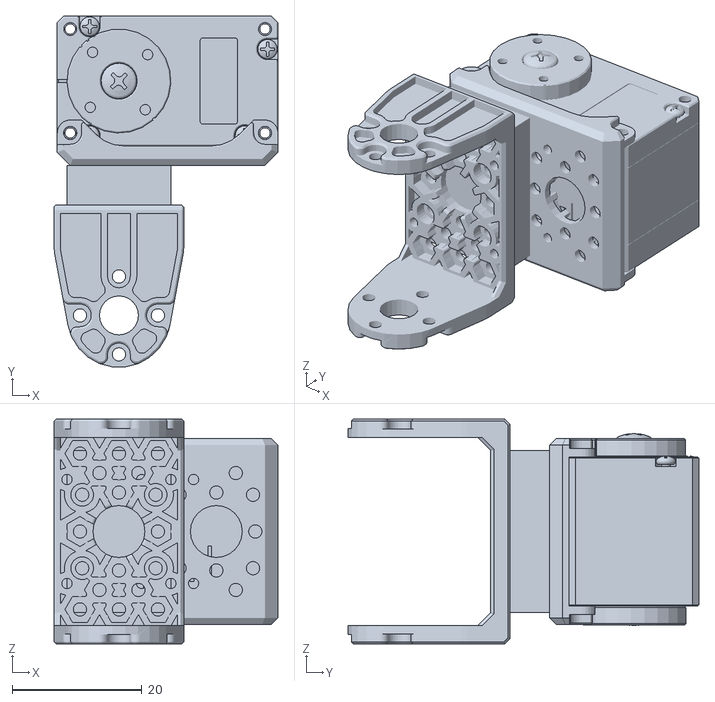
[picture p52: CAD file, 2026-10-15]
examples/stl/end_effectors/leap_hand/dip.stl
34.5 x 54.0 x 34.6
