mvanhorn/opentac/opentac/cad/web/example-meshes/yale_openhand_t42_proximal.stl

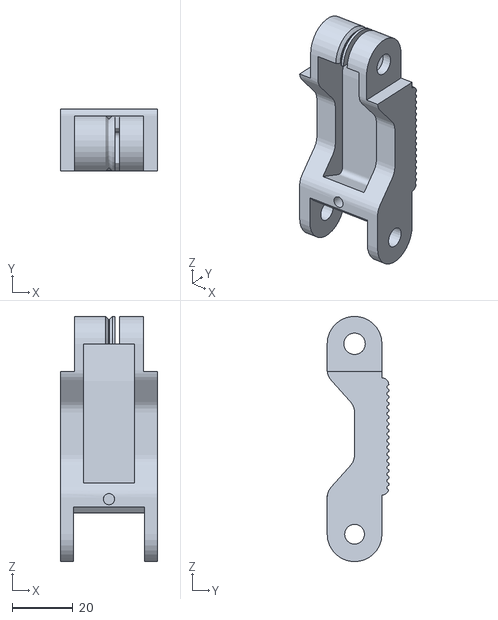
[picture p53: CAD file, 2026-10-15]
opentac/cad/web/example-meshes/yale_openhand_t42_proximal.stl
31.8 x 20.2 x 80.4
