mvanhorn/opentac/opentac/cad/web/example-meshes/yale_openhand_model_o_distal.stl

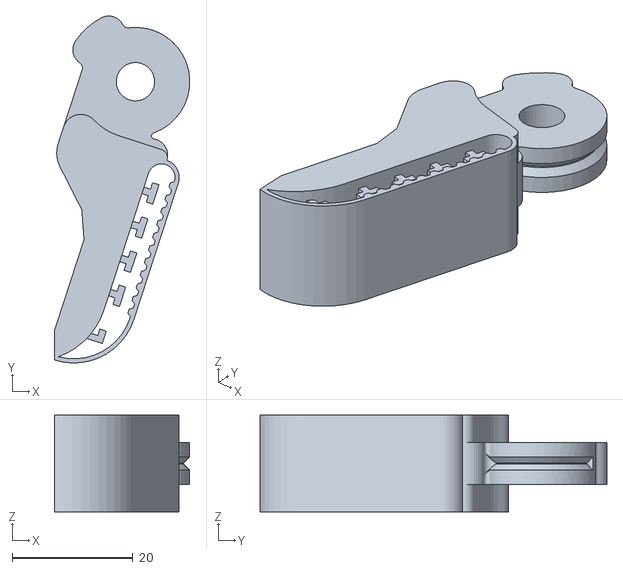
[picture p54: CAD file, 2026-10-15]
opentac/cad/web/example-meshes/yale_openhand_model_o_distal.stl
22.4 x 57.5 x 16.0
