mvanhorn/opentac/opentac/cad/web/example-meshes/Moving_Jaw_08d.stl

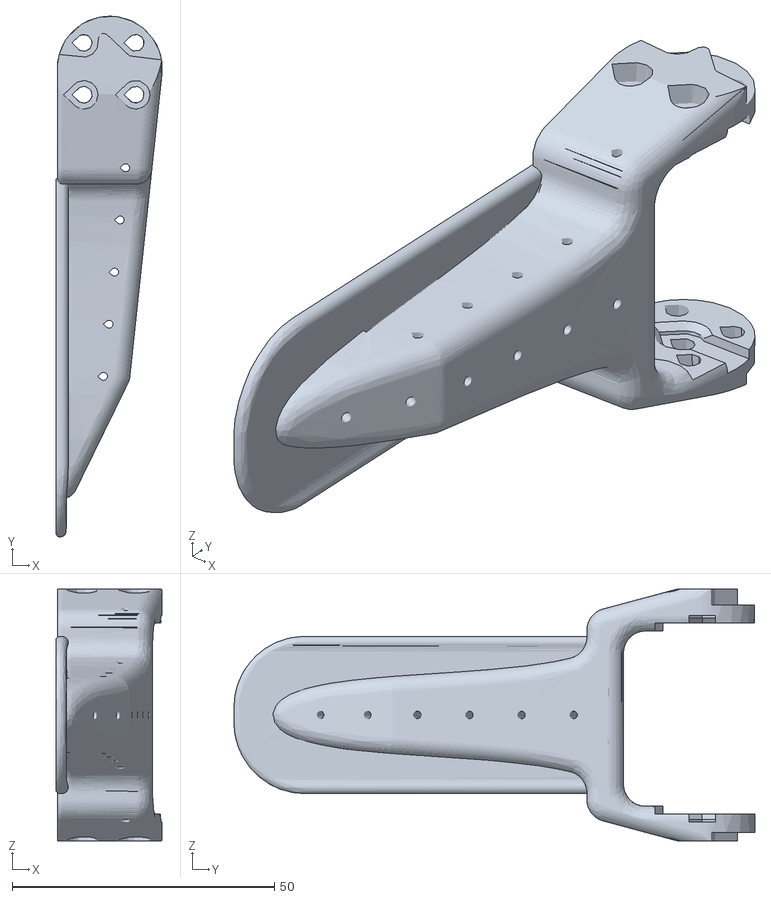
[picture p55: CAD file, 2026-10-15]
opentac/cad/web/example-meshes/Moving_Jaw_08d.stl
20.3 x 99.4 x 48.0
