mvanhorn/opentac/opentac/cad/web/example-meshes/leap_hand_pip.stl

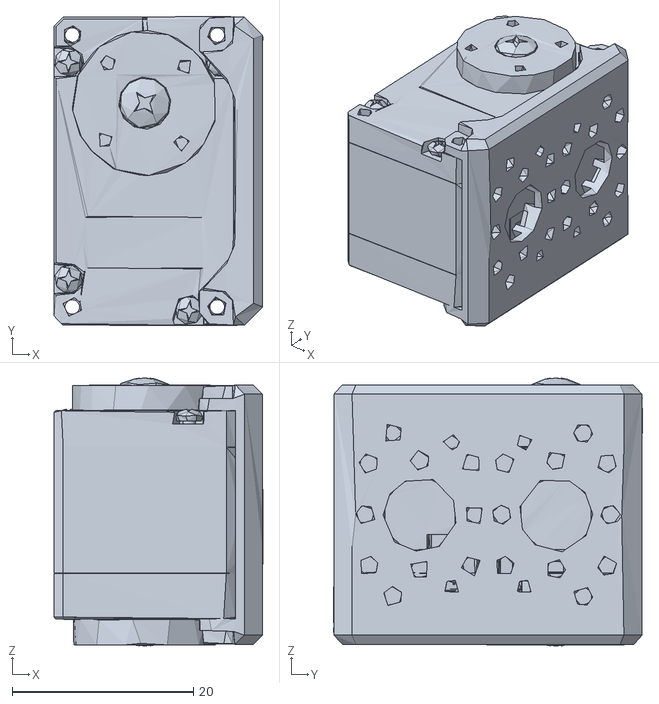
[picture p56: CAD file, 2026-10-15]
opentac/cad/web/example-meshes/leap_hand_pip.stl
23.0 x 34.1 x 29.6
