mvanhorn/opentac/opentac/cad/web/example-meshes/Wrist_Roll_08c.stl

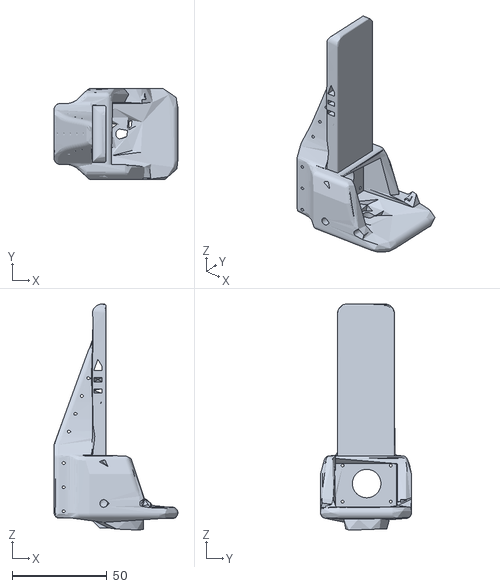
[picture p57: CAD file, 2026-10-15]
opentac/cad/web/example-meshes/Wrist_Roll_08c.stl
65.2 x 48.0 x 119.1
