mvanhorn/opentac/opentac/cad/web/example-meshes/onrobot_rg6_inner_finger.stl

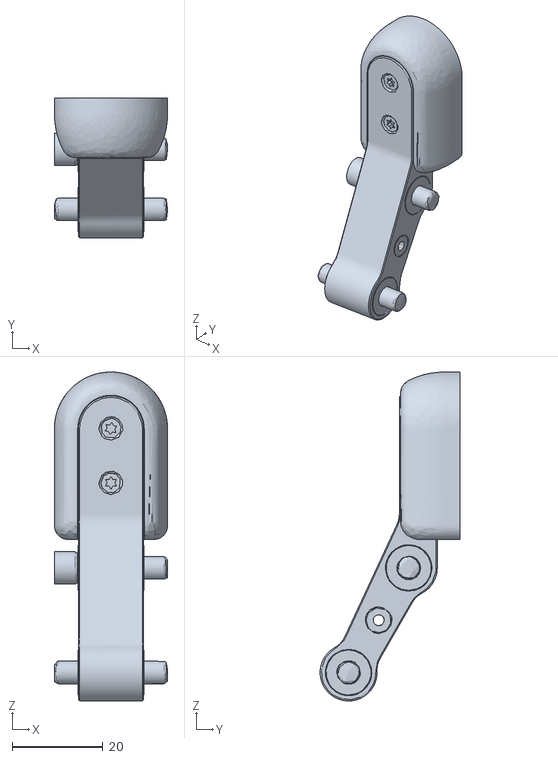
[picture p58: CAD file, 2026-10-15]
opentac/cad/web/example-meshes/onrobot_rg6_inner_finger.stl
25.0 x 30.9 x 72.7
