mvanhorn/opentac/opentac/cad/web/example-meshes/leap_hand_palm.stl

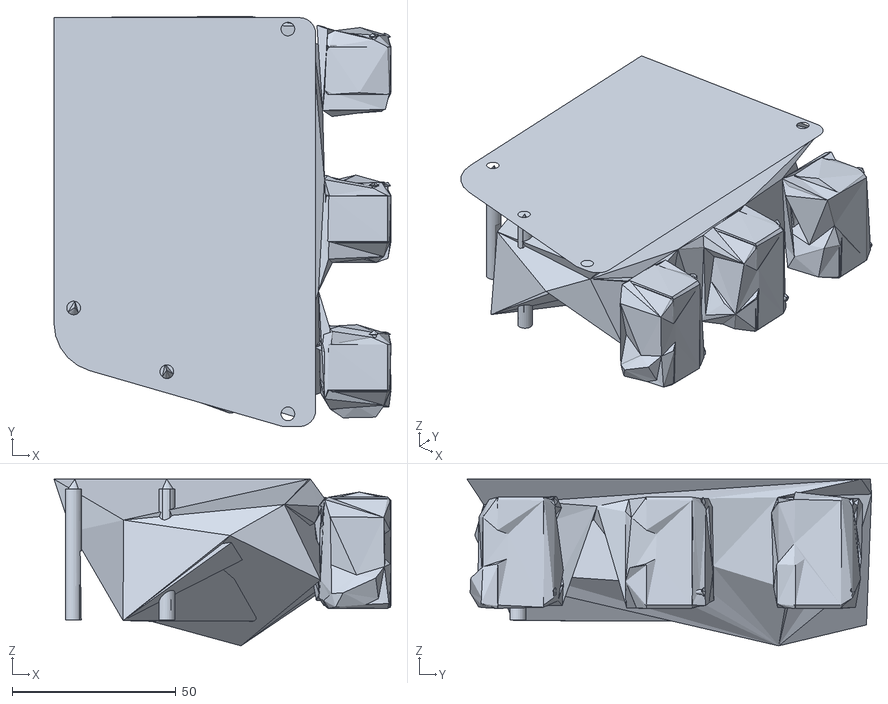
[picture p59: CAD file, 2026-10-15]
opentac/cad/web/example-meshes/leap_hand_palm.stl
103.0 x 125.4 x 51.0
