mvanhorn/opentac/opentac/cad/web/example-meshes/leap_hand_thumb_fingertip.stl

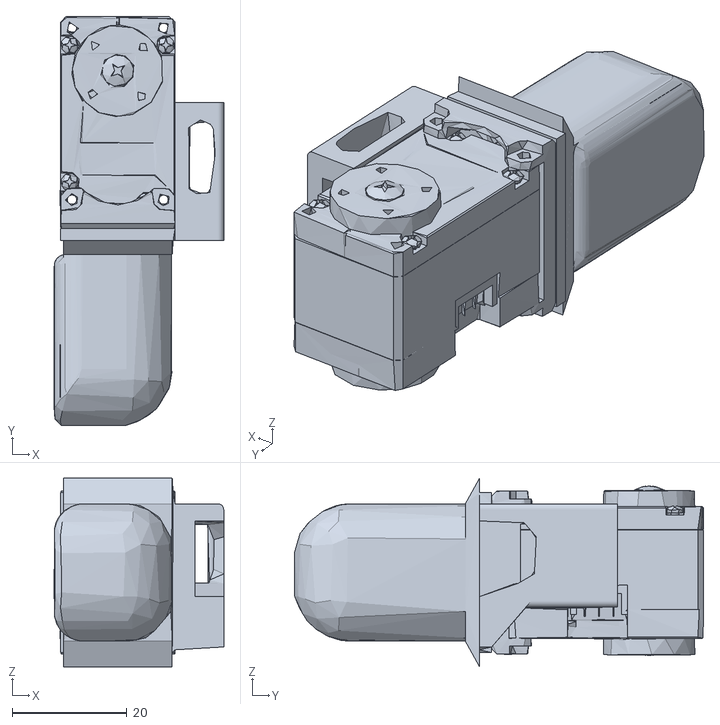
[picture p60: CAD file, 2026-10-15]
opentac/cad/web/example-meshes/leap_hand_thumb_fingertip.stl
29.6 x 71.4 x 33.0
