mvanhorn/opentac/opentac/cad/web/example-meshes/inspire_hand_palm.stl

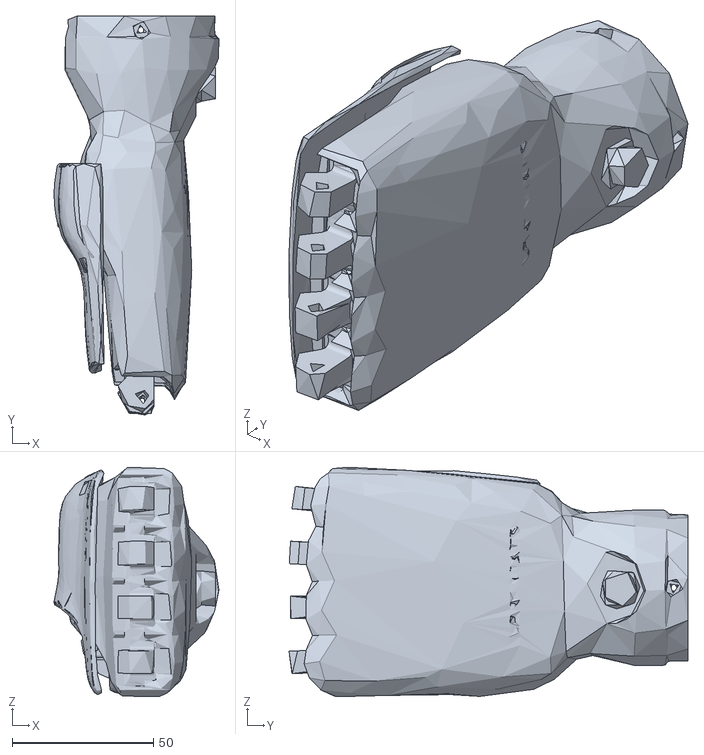
[picture p61: CAD file, 2026-10-15]
opentac/cad/web/example-meshes/inspire_hand_palm.stl
58.4 x 141.2 x 81.2
