mvanhorn/opentac/opentac/cad/web/example-meshes/umi_soft_gripper_finger.stl

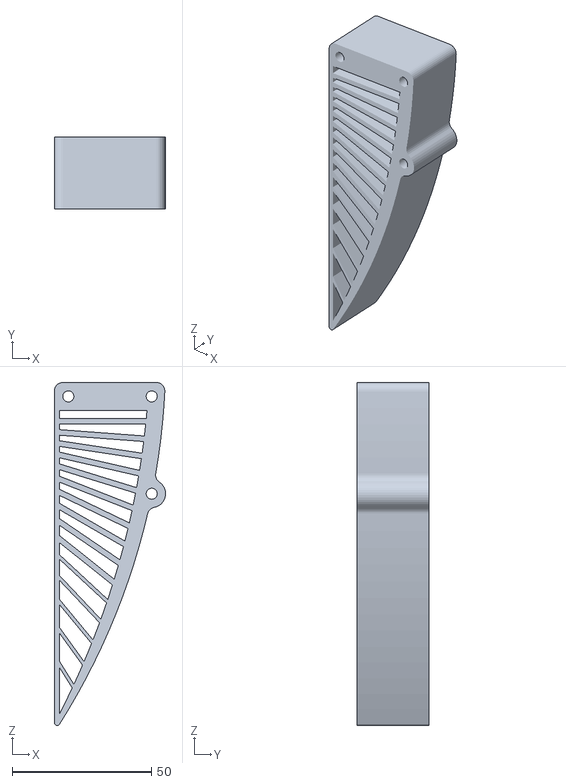
[picture p62: CAD file, 2026-10-15]
opentac/cad/web/example-meshes/umi_soft_gripper_finger.stl
40.0 x 25.8 x 123.4
