mvanhorn/opentac/(list of files, cad)

Other CAD files:
examples/stl/end_effectors/allegro/fingertip.stl
examples/stl/end_effectors/umi/jaw_left.stl
examples/stl/end_effectors/agilex_piper/jaw_link8.stl
examples/stl/end_effectors/allegro/palm.stl
examples/stl/end_effectors/unitree_dex3/distal_finger.stl
opentac/cad/web/example-meshes/leap_hand_mcp_joint.stl
examples/stl/end_effectors/xarm_gripper/left_finger.stl
opentac/cad/web/example-meshes/agilex_piper_jaw_link8.stl
opentac/cad/web/example-meshes/so101_fixed_jaw_wrist_roll.stl
opentac/cad/web/example-meshes/allegro_fingertip.stl
opentac/cad/web/example-meshes/FINGER_PAD_t30_L.stl
opentac/cad/web/example-meshes/allegro_thumb_fingertip.stl
opentac/cad/web/example-meshes/so101_moving_jaw.stl
opentac/cad/web/example-meshes/franka_fingertip.stl
opentac/cad/web/example-meshes/xarm_gripper_left_finger.stl
opentac/cad/web/example-meshes/xarm_gripper_lite_finger.stl
opentac/cad/web/example-meshes/onrobot_rg2_inner_finger.stl
opentac/cad/web/example-meshes/xarm_gripper_right_finger.stl
opentac/cad/web/example-meshes/franka_hand_body.stl
opentac/cad/web/example-meshes/schunk_sdh_finger_tip.stl
opentac/cad/web/example-meshes/robotiq_2f140_inner_finger.stl
opentac/cad/web/example-meshes/leap_hand_fingertip.stl
