mvanhorn/opentac/hardware/readout_30pin/bottom/readout_30pin_bottom.kicad_pcb

## KiCad design hardware/readout_30pin/bottom/readout_30pin_bottom.kicad_pcb (2026-10-16)

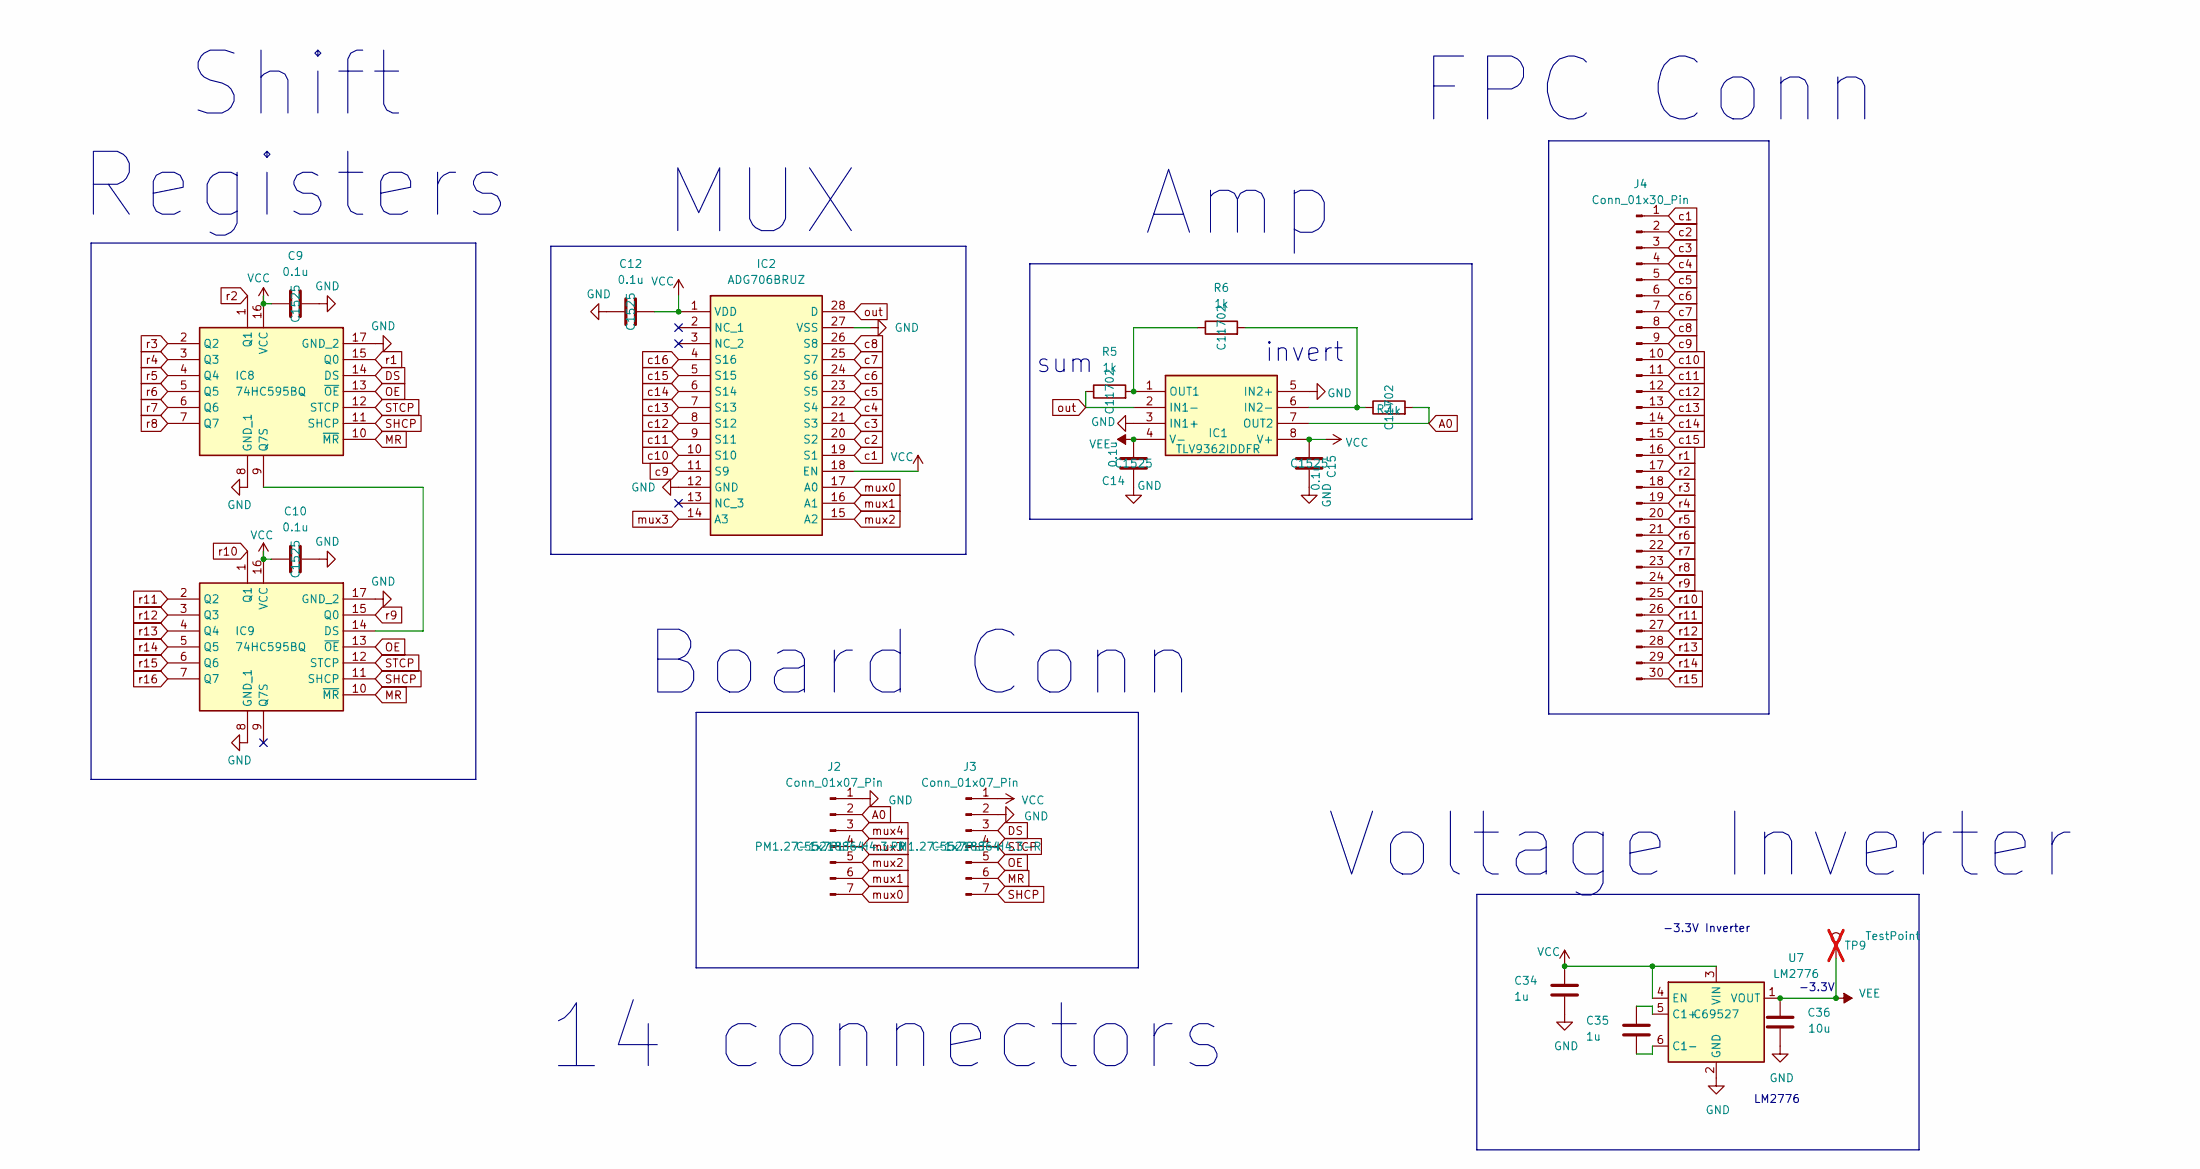
[picture p63: schematic readout_30pin_bottom.kicad_sch]

Parts:
C9, C10, C12, C14, C15: 0.1u; C_0402_1005Metric; LCSC Part # C1525
C34, C35: 1u; C_0402_1005Metric; LCSC Part # C52923
C36: 10u; C_0402_1005Metric; LCSC Part # C15525
IC1: TLV9362IDDFR; SOT65P280X110-8N; Manufacturer_Part_Number TLV9362IDDFR; LCSC Part # C5119287
IC2: ADG706BRUZ; SOP65P638X110-28N; Manufacturer_Part_Number ADG706BRUZ; LCSC Part # C579088
IC8, IC9: 74HC595BQ; NVT2006BQ115; Manufacturer_Part_Number 74HC595BQ; LCSC Part # C730243
J2, J3: Conn_01x07_Pin; PinSocket_1x07_P1.27mm_Vertical_SMD_Pin1Right; Manufacturer Part PM1.27-1x7PLT-H4.3-R; LCSC Part # C55218864
J4: Conn_01x30_Pin; CON_5051103091_MOL; Manufacturer_Part_Number 5051103091; LCSC Part # C588008
R5, R6, R7: 1k; R_0402_1005Metric; LCSC Part # C11702
TP9: TestPoint; TestPoint_Pad_1.0x1.0mm; not fitted
U7: LM2776; SOT-23-6; LCSC Part # C69527

Connections:
A0: IC1.7 (OUT2), J2.2, R7.2
DS: IC8.14 (DS), J3.3
GND: C9.2, C10.2, C12.2, C14.2, C15.2, C34.2, C36.2, IC1.3 (IN1+), IC1.5 (IN2+), IC2.12 (GND), IC2.27 (VSS), IC8.8 (GND_1), IC8.17 (GND_2), IC9.8 (GND_1), IC9.17 (GND_2), J2.1, J3.2, U7.2 (GND)
MR: IC8.10 (~MR), IC9.10 (~MR), J3.6
unnamed: IC1.6 (IN2-), R6.2, R7.1
unnamed: IC1.1 (OUT1), R5.2, R6.1
unnamed: IC8.9 (Q7S), IC9.14 (DS)
unnamed: C35.1, U7.5 (C1+)
unnamed: C35.2, U7.6 (C1-)
OE: IC8.13 (~OE), IC9.13 (~OE), J3.5
SHCP: IC8.11 (SHCP), IC9.11 (SHCP), J3.7
STCP: IC8.12 (STCP), IC9.12 (STCP), J3.4
VCC: C9.1, C10.1, C12.1, C15.1, C34.1, IC1.8 (V+), IC2.1 (VDD), IC2.18 (EN), IC8.16 (VCC), IC9.16 (VCC), J3.1, U7.3 (VIN), U7.4 (EN)
VEE: C14.1, C36.1, IC1.4 (V-), TP9.1, U7.1 (VOUT)
c1: IC2.19 (S1), J4.1
c2: IC2.20 (S2), J4.2
c3: IC2.21 (S3), J4.3
c4: IC2.22 (S4), J4.4
c5: IC2.23 (S5), J4.5
c6: IC2.24 (S6), J4.6
c7: IC2.25 (S7), J4.7
c8: IC2.26 (S8), J4.8
c9: IC2.11 (S9), J4.9
c10: IC2.10 (S10), J4.10
c11: IC2.9 (S11), J4.11
c12: IC2.8 (S12), J4.12
c13: IC2.7 (S13), J4.13
c14: IC2.6 (S14), J4.14
c15: IC2.5 (S15), J4.15
c16: IC2.4 (S16)
mux0: IC2.17 (A0), J2.7
mux1: IC2.16 (A1), J2.6
mux2: IC2.15 (A2), J2.5
mux3: IC2.14 (A3), J2.4
mux4: J2.3
out: IC1.2 (IN1-), IC2.28 (D), R5.1
r1: IC8.15 (Q0), J4.16
r2: IC8.1 (Q1), J4.17
r3: IC8.2 (Q2), J4.18
r4: IC8.3 (Q3), J4.19
r5: IC8.4 (Q4), J4.20
r6: IC8.5 (Q5), J4.21
r7: IC8.6 (Q6), J4.22
r8: IC8.7 (Q7), J4.23
r9: IC9.15 (Q0), J4.24
r10: IC9.1 (Q1), J4.25
r11: IC9.2 (Q2), J4.26
r12: IC9.3 (Q3), J4.27
r13: IC9.4 (Q4), J4.28
r14: IC9.5 (Q5), J4.29
r15: IC9.6 (Q6), J4.30
r16: IC9.7 (Q7)

Notes on the sheet:
LM2776
-3.3V
-3.3V Inverter
Board Conn
sum
MUX
Voltage Inverter
FPC Conn
Amp
invert
Shift Registers
14 connectors

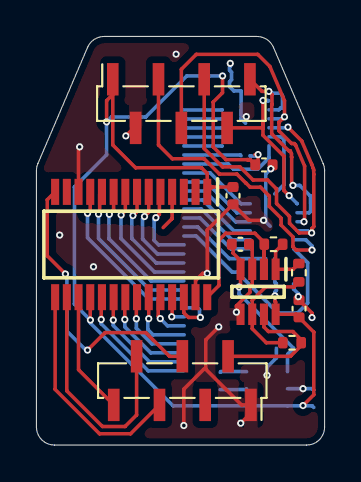
[picture p64: board readout_30pin_bottom.kicad_pcb from above]

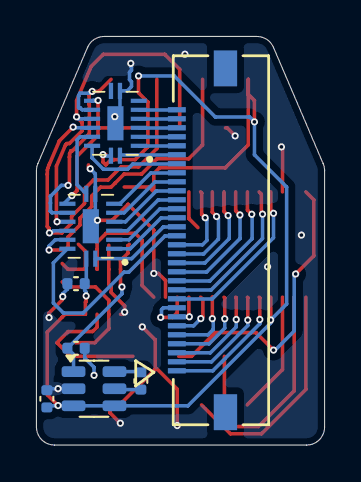
[picture p65: board readout_30pin_bottom.kicad_pcb from below]

Board: 2 copper layers, 16.0 x 22.7 mm, 19 parts (8 on the bottom side), 49 nets.
