mvanhorn/opentac/hardware/readout_60pin/readout_60pin.kicad_pcb

## KiCad design hardware/readout_60pin/readout_60pin.kicad_pcb (2026-10-16)

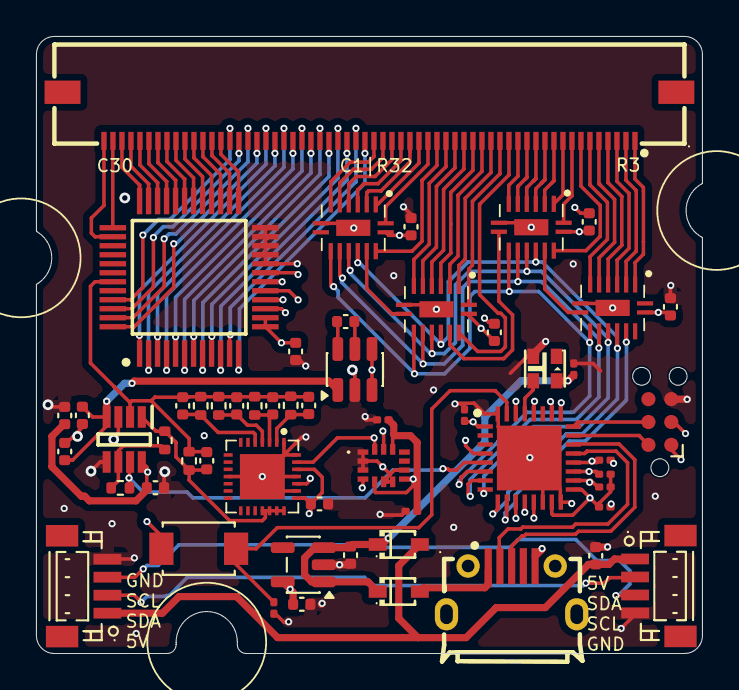
[picture p66: board readout_60pin.kicad_pcb from above]

Board: 4 copper layers, 37.0 x 34.3 mm, 55 parts (0 on the bottom side), 101 nets.

Parts:
C1, C9, C10, C13, C14, C15, C17, C60: 0.1u; C_0402_1005Metric
C2, C3, C16, C31, C32: 0.1u; C_0201_0603Metric
C28, C36, C38, C39: 10u; C_0402_1005Metric
C34, C35: 1u; C_0402_1005Metric
C52: 47p; C_0402_1005Metric
C54: 100p; C_0402_1005Metric
C55: 470p; C_0402_1005Metric
C57: 1.8n; C_0402_1005Metric
C59: 6.8n; C_0402_1005Metric
CN1, CN2: BM04B-SRSS-TB(LF)(SN); C160390_CONN-SMD_BM04B-SRSS-TB
D1, D3: 1N5819WS; C191023_SOD-323_L1_8-W1_3-LS2_5-RD
IC1: TLV9362IDDFR; SOT65P280X110-8N
IC3: STM32G431KBU6; QFN50P500X500X60-33N-D
IC4: ADG732BSUZ; QFP50P900X900X120-48N
IC5: LSM6DSV16BXTR
IC8, IC9, IC11, IC12: 74HC595BQ; NVT2006BQ115
J2: Conn_ARM_SWD_TagConnect_TC2030-NL; Tag-Connect_TC2030-IDC-NL_2x03_P1.27mm_Vertical
J4: 5051106091; C493444_FPC-SMD_5051106091
LED1: XL-2020RGBC-WS2812B; C5349955_LED-SMD_4P-L2_0-W2_0-BR-1
R4: 10k; R_0201_0603Metric
R6, R7: 1k; R_0402_1005Metric
R18: 100k; R_0201_0603Metric
R19, R20: 4.7k; R_0201_0603Metric
R21: 10k; R_0402_1005Metric
R23: 4.7k; R_0402_1005Metric
R24: 1.1k; R_0402_1005Metric
R26: 270; R_0402_1005Metric
R28: 68; R_0402_1005Metric
S4: TS-1088-AR02016; SW_TS-1088-AR02016
U1: TLV75533PDBV; SOT-23-5
U7: LM2776; SOT-23-6
U10: MAX14662ETI+T; C2673377_TQFN-28_L4_0-W4_0-P0_40-BL-EP
USB2: MicroXNJ; C404969_MICRO-USB-SMD_MICROXNJ_1

Connections:
5V: C28.1, CN1.1, CN2.1, D1.2 (A)
5V-led: C16.1, C39.1, D1.1 (K), D3.1 (K), LED1.4 (VDD), U1.1 (IN), U1.3 (EN)
/FB1: C54.2, R23.2, U10.2 (A1)
/FB2: C55.2, R24.2, U10.3 (A2)
/FB3: C57.2, R26.2, U10.4 (A3)
/FB4: C59.2, R28.2, U10.5 (A4)
/TIA_OUT: C52.2, IC1.1 (OUT1), R6.1, R21.2, U10.18 (B4), U10.19 (B3), U10.20 (B2), U10.21 (B1)
A0: IC1.7 (OUT2), IC3.5 (PA0), R7.2
D+: IC3.22 (PA12), USB2.3 (D+)
D-: IC3.21 (PA11), USB2.2 (D-)
DS: IC3.10 (PA5), IC8.14 (DS)
GND: C1.2, C2.1, C3.1, C9.2, C10.2, C13.2, C14.2, C15.2, C16.2, C17.2, C28.2, C31.2, C32.2, C34.2, C36.2, C38.2, C39.2, C60.2, CN1.4, CN2.4, IC1.3 (IN1+), IC1.5 (IN2+), IC3.14 (VSSA), IC3.16 (VSS_1), IC3.32 (VSS_2), IC3.33 (EP), IC4.20 (~CS), IC4.21 (~WR), IC4.22 (~EN), IC4.23 (GND), IC4.24 (VSS), IC5.1 (SDO/SA0), IC5.2 (TDMOUT), IC5.3 (BCLK), IC5.6 (AH1/QVAR1), IC5.7 (GND), IC5.9 (AH2/QVAR2), IC8.8 (GND_1), IC8.17 (GND_2), IC9.8 (GND_1), IC9.17 (GND_2), IC11.8 (GND_1), IC11.17 (GND_2), IC12.8 (GND_1), IC12.17 (GND_2), J2.5 (GND), LED1.2 (GND), R4.1, R18.2, U1.2 (GND), U7.2 (GND), U10.1 (SPI/I2C#), U10.11 (GND), U10.23 (CS#/AD0), U10.25 (GND), U10.28 (DOUT/AD1), U10.29 (EP), USB2.5 (GND)
IMU_INT: IC3.13 (PB0), IC5.4 (INT1)
MR: IC3.6 (PA1), IC8.10 (~MR), IC9.10 (~MR), IC11.10 (~MR), IC12.10 (~MR)
NRST: IC3.4 (PG10-NRST), J2.3 (~RESET)
unnamed: IC1.6 (IN2-), R6.2, R7.1
unnamed: IC3.29 (PB6), LED1.3 (DI)
unnamed: IC3.31 (PB8-BOOT0), R4.2, S4.2
unnamed: IC8.9 (Q7S), IC9.14 (DS)
unnamed: IC9.9 (Q7S), IC11.14 (DS)
unnamed: IC11.9 (Q7S), IC12.14 (DS)
unnamed: C35.1, U7.5 (C1+)
unnamed: C35.2, U7.6 (C1-)
OE: IC3.9 (PA4), IC8.13 (~OE), IC9.13 (~OE), IC11.13 (~OE), IC12.13 (~OE)
SCL: IC3.19 (PA9), IC5.13 (SCL), R20.2, U10.24 (SCLK/SCL)
SDA: IC3.18 (PA8), IC5.14 (SDA), R19.2, U10.27 (DIN/SDA)
SHCP: IC3.7 (PA2), IC8.11 (SHCP), IC9.11 (SHCP), IC11.11 (SHCP), IC12.11 (SHCP)
STCP: IC3.8 (PA3), IC8.12 (STCP), IC9.12 (STCP), IC11.12 (STCP), IC12.12 (STCP)
SWCLK: IC3.24 (PA14), J2.4 (SWCLK)
SWDIO: IC3.23 (PA13), J2.2 (SWDIO)
VBUS: D3.2 (A), USB2.1 (VBUS)
VCC: C1.1, C2.2, C3.2, C9.1, C10.1, C13.1, C15.1, C17.1, C31.1, C32.1, C34.1, C38.1, C60.1, IC1.8 (V+), IC3.1 (VDD_1), IC3.15 (VDDA), IC3.17 (VDD_2), IC4.13 (VDD_1), IC4.14 (VDD_2), IC5.5 (VDD_IO), IC5.8 (VDD), IC5.12 (CS), IC8.16 (VCC), IC9.16 (VCC), IC11.16 (VCC), IC12.16 (VCC), J2.1 (VCC), R19.1, R20.1, S4.1, U1.5 (OUT), U7.3 (VIN), U7.4 (EN), U10.22 (SD#), U10.26 (VCC)
VEE: C14.1, C36.1, IC1.4 (V-), U7.1 (VOUT)
c1: IC4.12 (S1), J4.31
c2: IC4.11 (S2), J4.32
c3: IC4.10 (S3), J4.33
c4: IC4.9 (S4), J4.34
c5: IC4.8 (S5), J4.35
c6: IC4.7 (S6), J4.36
c7: IC4.6 (S7), J4.37
c8: IC4.5 (S8), J4.38
c9: IC4.4 (S9), J4.39
c10: IC4.3 (S10), J4.40
c11: IC4.2 (S11), J4.41
c12: IC4.1 (S12), J4.42
c13: IC4.48 (S13), J4.43
c14: IC4.47 (S14), J4.44
c15: IC4.46 (S15), J4.45
c16: IC4.45 (S16), J4.46
c17: IC4.25 (S17), J4.47
c18: IC4.26 (S18), J4.48
c19: IC4.27 (S19), J4.49
c20: IC4.28 (S20), J4.50
c21: IC4.29 (S21), J4.51
c22: IC4.30 (S22), J4.52
c23: IC4.31 (S23), J4.53
c24: IC4.32 (S24), J4.54
c25: IC4.33 (S25), J4.55
c26: IC4.34 (S26), J4.56
c27: IC4.35 (S27), J4.57
c28: IC4.36 (S28), J4.58
c29: IC4.37 (S29), J4.59
c30: IC4.38 (S30), J4.60
mux0: IC3.11 (PA6), IC4.15 (A0)
mux1: IC3.12 (PA7), IC4.16 (A1)
mux2: IC3.20 (PA10), IC4.17 (A2), R18.1
mux3: IC3.26 (PB3), IC4.18 (A3)
mux4: IC3.28 (PB5), IC4.19 (A4)
out: C52.1, C54.1, C55.1, C57.1, C59.1, IC1.2 (IN1-), IC4.43 (D), R21.1, R23.1, R24.1, R26.1, R28.1
r3: IC8.2 (Q2), J4.1
r4: IC8.3 (Q3), J4.2
r5: IC8.4 (Q4), J4.3
r6: IC8.5 (Q5), J4.4
r7: IC8.6 (Q6), J4.5
r8: IC8.7 (Q7), J4.6
r9: IC9.15 (Q0), J4.7
r10: IC9.1 (Q1), J4.8
r11: IC9.2 (Q2), J4.9
r12: IC9.3 (Q3), J4.10
r13: IC9.4 (Q4), J4.11
r14: IC9.5 (Q5), J4.12
r15: IC9.6 (Q6), J4.13
r16: IC9.7 (Q7), J4.14
r17: IC11.15 (Q0), J4.15
r18: IC11.1 (Q1), J4.16
r19: IC11.2 (Q2), J4.17
r20: IC11.3 (Q3), J4.18
r21: IC11.4 (Q4), J4.19
r22: IC11.5 (Q5), J4.20
r23: IC11.6 (Q6), J4.21
r24: IC11.7 (Q7), J4.22
r25: IC12.15 (Q0), J4.23
r26: IC12.1 (Q1), J4.24
r27: IC12.2 (Q2), J4.25
r28: IC12.3 (Q3), J4.26
r29: IC12.4 (Q4), J4.27
r30: IC12.5 (Q5), J4.28
r31: IC12.6 (Q6), J4.29
r32: IC12.7 (Q7), J4.30
scl-bus: CN1.3, CN2.3, IC3.25 (PA15)
sda-bus: CN1.2, CN2.2, IC3.30 (PB7)
