mvanhorn/opentac/(commit log)

2026-10-15 Repo skeleton: one Python package (uv), docs site config, CI
    Library versions in uv.lock match the CAD backend's verified environment
    (numpy 2.5.1, shapely 2.0.6, trimesh 4.12.2, ...) so the port can be checked
    for identical output before anything is upgraded.
2026-10-15 Port the CAD tool into opentac.cad
    Source: custom_pcb_dev inner-layers (backend 52fcfdb, frontend a755be1), plus
    main's printable-PDF fix (1e23732) and the uncommitted route_hug.py crash fix
    of 2026-10-14. Moves only, no behaviour changes:
    backend/{main,pipeline,export,importers,chat,connectors} -> opentac/cad/
    frontend/ -> opentac/cad/web/
    backend/tests/ -> tests/cad/
    stl_examples/ -> examples/stl/
    local_launcher.py -> opentac/cad/launcher.py, run by 'opentac cad'
    Start_OpenTactileCAD.* -> Start_OpenTac.* (one line: uv run opentac cad)
    Imports become opentac.cad.*; the sys.path inserts in tests and the skill's
    backend lookup are gone. The chat test skips wit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
2026-10-15 Remove bump anchor holes (pegs)
    The feature never shipped: its UI section was hidden. Removed are the five
    anchor_hole* params, pipeline/anchor_holes.py, the packer's step-pattern
    support (only anchor holes used it), the cutouts in the Gerber, KiCad, SVG and
    velostat writers, the bump-centre override, the manifest's anchor branch, the
    stats rows and the hidden frontend section.
    Compatibility: saved designs still carry these keys. Loading drops them, and a
    design that had anchor holes switched on is refused with a clear message rather
    than rebuilt without its cutouts (pipeline/types.drop_removed_params). The QR
    format keeps its bit, now always 0, so existing boards' codes still decode.
    Chec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
2026-10-15 Remove the superseded bump-sheet panel
    The printed-case panel covers it: its top piece can be flat, hatched or
    bumped. The old 'Add shear-sensing bumps / Generate bump sheet' panel and
    bump-sheet.js are gone; bump-viewer.js stays (the case uses it). The help
    section now describes the case and its three lids with the case panel's own
    field names, and the case panel links to it.
    The /bump-sheet endpoint is kept for now: tests use it to check that the
    case's bumps land where the bump sheet's did.
    Checked in headless Chrome: draw, generate, build a bumped case, switch input
    modes and open help, with no page errors.
2026-10-15 Simplify the tool: cut controls Arik marked in the review
    From the control review (claude.ai/artifact/YDrAJRMdKipzZockpAZxyj):
    - Hug routing checkbox: gone; the page always sends router=hug.
    - Test-shape presets L, C, Deep C, U, T, Eight: gone (Square, Rect, Foot stay).
    - Advanced board-shape controls (routing margin, follow padding, smooth edge)
    and the shoulder-fillet field: gone. The page no longer sends them, so the
    backend defaults apply, which are the values the fields held; fixed-outline
    mode already turns follow padding off server-side.
    - Yellow tail-extension prompt after every Generate: gone.
    Help text updated to describe the board edge and fillet as automatic.
    Checked in he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
2026-10-15 Shared Frame type and a minimal manifest loader
    Frame is what read() returns from the hardware and from the simulator alike.
    opentac.manifest.load reads a manifest.json, a design export zip or a dict;
    validation, version upgrades and QR recovery build on it.
2026-10-15 Port simulation (foam model, TactileSim bump model) and sensor transfer
    opentac.sim.Sensor(manifest, model='foam'|'mujoco') returns Frames.
    foam: the paper's Winkler foam contact model (sigma 3.00 mm, k 0.00866 N/mm^3).
    mujoco: TactileSim ported as opentac.sim.mujoco (flat only), surrogate or full solver.
    opentac.transfer: force-conserving area resample between two skins' manifests.
    Regression fixtures computed by the original lab scripts (tests/sim/make_reference.py).
2026-10-15 Firmware: readout sketch, bus library and controller, build.sh
    Copied unchanged from stm_test/tactile_imu_fast_cfg (renamed opentac_readout),
    libraries/OpenTactileBus and v2/ot2_master (renamed bus_controller), with the
    host tests. build.sh builds every target with arduino-cli into firmware/build/.
    Checked: NODE16 and READOUT32 built here are byte-identical to the prebuilt
    bins of 2026-10-02, and the controller hex to v2/build/ot2_master.hex. The
    bin depends on arduino-cli's link mode (archives when the object paths pass
    30000 characters), so build.sh uses a long build folder to fix it.
2026-10-15 Firmware: 60-pin board (OT_BOARD_READOUT60) with its gain switch
    - '595 control lines in the 60-pin board's order (PA1 MR, PA2 SHCP, PA3 STCP,
    PA4 OE, PA5 DS), as macros the scan's BSRR writes now use.
    - GAIN_SW (parameter 35, 60-pin only): the MAX14662 at I2C 0x4C, register
    0x00, bit k = SW(k+1). Boots at 0 (all open, 10k feedback), the chip's own
    power-on state. Written and read back from loop(); a change drops the
    xampling baseline.
    - A build must name exactly one board; the Arduino IDE way is a commented
    #define at the top of the sketch. The bus node stays NODE16-only.
    - OT_POST_DRAIN_US: opt-in wait after each IMU FIFO drain, 0 by default.
    NODE16 and READOUT32 bins are still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
2026-10-15 Connector tail: solder mask open on the contact side only
    The Molex 505110 on both readout boards is a bottom-contact connector, and the
    tail's contacts are on the bottom copper (confirmed by Arik). Every connector pad
    used to open the mask on both sides, so the polyimide stiffener had to sit on
    exposed copper and JLCPCB asked about it on every order.
    Connector pads now open B.Mask only (all ten footprints); the top stays covered
    under the stiffener. The KiCad writer takes each pad's layers from the footprint
    instead of hardcoding both masks, and the drawing-layer note now reads 'PI
    stiffener on TOP (taxel side), T = 0.3 total, contacts on BOTTOM'.
    Checked on both Gerber paths (kicad-cli a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
2026-10-15 Readout board choice: the 30-pin or 60-pin board instead of any connector size
    New readout_board setting ('auto', '30pin', '60pin', or 'any' through the API).
    Auto uses the 30-pin board (up to 15 x 15 taxels) when the grid fits, else the
    60-pin board (up to 30 x 30). Both boards wire one connector half to the drive
    side and the other to the sense side, which is exactly the tool's pad split, so
    rows and columns always land on opposite halves; tests/cad/test_readout_board_pads
    checks that across grid sizes. A grid too big for the board fails with a message
    naming the limit. connector_pos_override still wins for other hardware.
    Fixed-outline mode sizes its wiring band from a provisional full p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
2026-10-15 Skill: readout boards, 4 copper layers, contact side, double curvature
    - Readout board and copper layers: the 30-pin (15 x 15) and 60-pin (30 x 30)
    limits per direction, readout_board auto/30pin/60pin, and when 4 copper layers
    pay off (D'Claw flat-top hexagon fingertip: 497 taxels on 4 layers vs 410 on 2).
    - Tail: contacts on the bottom copper, stiffener on the top, 0.3 mm total.
    - Doubly-curved surfaces cannot be sensorized: approximate with flat facets,
    preferably a flat-top hexagon unfolded into leaves (D'Claw 1-inch fingertip:
    5 columns per leaf, 30 columns, 4 layers, 546 taxels).
2026-10-15 Skill insole example: 8.6 mm pitch so the rows fit the 60-pin board
    At 8.0 mm the size-9 insole needs 31 rows, one more than the 60-pin readout
    board reads; the preflight now says so. 8.6 mm square taxels give 10 x 28,
    175 taxels, clean.
2026-10-15 Hosted demo: Render blueprint and Dockerfile from the one package
    deploy/Dockerfile installs the package with the [demo] extra (uv 0.12.18, the
    version that wrote uv.lock) and runs 'opentac cad' on port 10000; render.yaml
    defines the opentac-cad service with GEMINI_API_KEY as a secret. The page at
    opentac.github.io/cad/ calls https://opentac-cad.onrender.com, and CORS now
    admits opentac.github.io (and the old aslepyan.github.io) instead of '*'.
    Checked by assembling exactly the files the Dockerfile copies, installing them
    the same way and exercising the server: health, the 57 example STLs, generate,
    chat status, and a CORS request from opentac.github.io.
2026-10-15 Website: MkDocs Material site, home story, design/build docs, results, Pages workflow
    - mkdocs.yml: Material theme (ink + polyimide amber, IBM Plex, light/dark/auto),
    tabs nav including the pages other workstreams are writing.
    - Home (overrides/home.html + docs/index.md): hero with the skins photo,
    narrated overview video, then sense -> design -> build -> read -> xampling ->
    sim/transfer -> robots, with paper numbers only.
    - Pages: get-started, design/{index,shapes,agent,export}, build/{index,
    order-sensor,order-readout,materials,assembly}, hardware, results (extensible
    Demos section), paper (BibTeX, authors/arXiv TODO).
    - Assets: paper figures (docs/assets/figures), photos incl. a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
2026-10-15 Example designs: sources (the 31 fabricated sensors) and the generator script
2026-10-15 Name: OpenTac CAD everywhere a person reads it
    The tool's page title, header, start-screen text, tour, chat preamble, API
    title, error messages and file metadata (design.json 'app', manifest readme,
    PDF titles). The 'run it on your own computer' card now points at the new repo
    and Start_OpenTac.command/.bat (uv-based). No reader keys on the old name, so
    existing exports still open. Also: the site footer states the licenses.
2026-10-15 Ready-to-order example designs and the public README
    The 31 sensors fabricated for the paper, regenerated by
    scripts/make_example_designs.py for the OpenTac readout boards: 9 on the 30-pin
    board, 22 on the 60-pin board, all 2-layer, all DRC 0. Each has a complete
    export zip and a preview SVG under docs/designs/files (8.3 MB in total), listed
    on docs/design/examples.md. The three designs fabricated with 32 rows have their
    pitch raised just enough to fit 30 (noted on the page).
    README: what OpenTac is, the quick start (uv, double-click launchers), readout
    commands, the agent skill, the folder map, the boards and the licenses.
2026-10-15 Add the 60-pin and 30-pin readout boards (KiCad, fab files, BOMs with MPN)
2026-10-15 Board renders and turntable loops, with the script that makes them
2026-10-15 hardware: keep third-party 3D models out of the public repo
    They come from LCSC/EasyEDA and manufacturers under their own terms and are only
    needed for the 3D view and the board renders (already made). The README lists
    the parts and how to fetch them; the folder is gitignored.
2026-10-15 Readout in Python: manifests, device, viewer, recording, calibration, CLI
    - opentac.manifest: validation with clear errors (versions 3-6), the bytes a
    manifest was read from (config id), drawn layout, from_qr() over
    taxel_core.manifest_from_scan.
    - opentac.device: Sensor and Bus (ported from opentac_device.py), config
    bytes, the line protocol, DFU flashing, and one wiring table per board in
    device/boards/*.json. setup() caches the manifest at
    ~/.opentac/manifests/<config_id>.json, and Sensor() finds it again.
    - READOUT60 wiring from the 60-pin netlist: line = 62 - pad. The same
    derivation reproduces the measured READOUT32 (67 - pad) and NODE16 maps.
    - opentac.view (single board a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
2026-10-15 Add the interactive "How it works" page (docs/learn)
    Five studies rebuilt from real sources: the sensor stack with real taxel
    copper and the row-column readout; one bump over a real 2x2 block (TactileSim
    statics + fitted film profile, labelled as a model); shear and twist decoded
    per bump on real layouts; transfer of real recorded presses between three
    skins (port of opentac_transfer's geometric step); and fixed-budget xampling
    replayed on a raster recording (port of ot_xampling.h).
    scripts/learn/build_data.py generates docs/learn/data from the manifests,
    recordings and firmware sources. check_xampling.py and check_transfer.py
    compare the page's JS ports with the compiled firmware header an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
2026-10-15 Readout docs and examples; flash finds bus nodes; QR decode errors become ManifestError
    docs/use: flash, sensor, xampling, daisy-chain, qr-recovery.
    docs/reference: manifest, protocol.
    examples: read_sensor.py, record_take.py, xampling.py (run against the test
    board stand-in).
2026-10-15 Integrate: top-level opentac.Sensor/Frame/load_manifest; sim fixtures at manifest v6
    opentac exposes Sensor, Bus, Frame and load_manifest lazily, as the README shows.
    The sim's two synthetic grid fixtures declared v 0, which the stricter manifest
    reader from the readout work rejects; they are v6 now.
    Integrated main: 450 tests pass (silk_label excluded, kicad-cli dependent as
    before), frontend tests pass, mkdocs --strict builds with no warnings.
2026-10-15 Docs: daisy-chaining is for 30-pin boards; the 60-pin firmware does not run as a node yet
2026-10-15 scripts/preview_site.py: the website, OpenTac CAD at /cad/ and its backend on one local address
2026-10-15 Name: OpenTac-CAD (as in the paper), everywhere
2026-10-15 Xampling: grow mode is the default and the docs say growth follows the whole contact
    Xampling grows past M around a contact; nothing is cut off. 'opentac view
    --xampling M' and Sensor.xampling(budget) now use grow mode (xamp_grow), with
    --fixed / grow=False for the steady-frame-rate fixed mode. The How-it-works
    study replays grow mode, and its text no longer says a large contact is never
    read whole. scripts/learn/check_xampling.py now checks both modes: the page's
    port picks the same taxels as the compiled ot_xampling.h on all 71,360 frames.
2026-10-15 Narrow tail: the cable is cut to its traces after routing and flares back to the connector
    The board is still laid out and routed with a connector-width tail, so the
    taxels and every trace are the same as before. narrow_tail.py then replaces
    that tail with a strip just wide enough for the traces (the board's usual
    2 mm padding on grown boards, the wire-to-edge distance on fixed outlines),
    a half-cosine flare (45 degrees at its steepest, no corner at either end)
    back to the tab width, and the full-width landing the connector's own
    Edge.Cuts continue from. Wires that fan in inside the tail keep the board
    around them, and the tail meets the board with 1 mm fillets. On by default
    (narrow_tail);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
2026-10-15 Readout boards: 30-pin bottom passives on 0402 parts; 60-pin back carries a QR to opentac.github.io
    From the current KiCad sources (3D model paths pointed at libs/3dmodels as
    before, nothing else changed):
    - 30-pin bottom (Sensor_30): the three passives listed 0805/0201 parts on 0402
    pads. Now C1525 (CL05B104KO5NNNC, 100 nF), C52923 (CL05A105KA5NQNC, 1 uF)
    and C11702 (0402WGF1001TCE, 1 kOhm), all JLCPCB Basic parts. Schematic,
    board, JLCPCB BOM, fab zip and bom.csv (MPN column) updated.
    - 60-pin: back silkscreen QR code linking to opentac.github.io; board and
    fab zip re-exported.
    KiCad DRC on both boards reports the same violations as before the update.
2026-10-15 Sensor QR prints a link to a decoder page on opentac.github.io
    The back-silkscreen QR now encodes HTTPS://OPENTAC.GITHUB.IO/Q/<payload>
    (every '/' in the payload printed as '*'), all in QR alphanumeric mode, so a
    phone camera opens a page instead of showing a string.
    - taxel_core: LINK_PREFIX, qr_link(), payload_from_text(). manifest_from_scan,
    manifest.from_qr, the CLI and /decode-backmark accept the link in any case,
    with or without https://, '*' or '/', the /qr/#<payload> address, and the
    bare payload old boards carry.
    - silk_backmark: the link if it fits inside the outline, else the bare payload
    (with a warning), else no QR as before. info carries form and text;
    /generate stat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
2026-10-15 hardware: .kicad_prl is per-user KiCad view state; untrack it and ignore it
2026-10-16 CAD page gets the site's favicon; readout ordering: tooling holes left to JLCPCB (the default), wording no longer guessed
2026-10-16 Readout boards: JST-SH (Qwiic) connectors use KiCad's model, which sits on the mounting pads
    The LCSC/EasyEDA model (C160390.wrl) has no solder tabs and a housing narrower at the board than at the top, so the two mounting pads showed bare beside each connector in the 3D view and the site's renders. KiCad's JST_SH_BM04B-SRSS-TB model fits the same pad pattern (rows 2.525 vs 2.52 mm apart), offset 0.065 mm. 3D model only: pads, nets and DRC unchanged (30-pin top 107, 60-pin 181 violations before and after). Board stills and turntable loops regenerated.
2026-10-16 CAD: Download ZIP includes the printed case
    The ZIP gets a case/ folder: <name>_case_bottom.stl, the bumped lid
    (<name>_case_top_bumps.stl) and the flat and hatched lids, plus a README
    naming the primary lid, the settings used and any case warnings.
    Built at download time by a new POST /zip-with-case (board ZIP + edit_data +
    case settings -> ZIP with case/), not inside /generate, so generation on the
    free tier is not slower. Both download paths (plain ZIP and the route
    editor's edited export) go through app.js downloadZip, which shows
    "Preparing download..." and a note under the download bar.
    Settings come from the case panel's fields (their defaults if untouched);
    the lid choice only pick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
2026-10-16 Case: cut every hatch piece, also when shapely returns a GeometryCollection
    The gallery's 40 x 40 square, generated as the page does, got a hatch back as a GeometryCollection (polygons plus a sliver), which build_case cut as one piece: the hatched lid lost 6 mm^3 instead of ~390. _polygons() unpacks any result type for every lid cutter. Regression test on that board. Also: design-import test expects the app name OpenTac-CAD.
2026-10-16 OpenTac-CAD: an 'OpenTac website' link in the header, and the assembly guide linked from the download bar, the case panel and Help > Exporting
    The links open in a new tab, so the design on screen is kept. Served under
    <site>/cad/ (Pages, preview_site.py) they point one level up; run by
    'opentac cad' they point at https://opentac.github.io/. The download bar
    wraps at phone width.
2026-10-16 QR decoder page: draw the sensor and list every field the code carries
    After a decode the page now shows, from the decoded taxel core:
    - the sensor to scale, seen from the taxel side: each taxel's interdigitated
    copper (or a rectangle when too small to read), empty grid positions dashed,
    row/column numbers and their connector contacts along the edges, the origin
    (middle of the cable edge), and the connector contacts at their x positions
    below it, with a mm scale bar
    - one taxel's copper with its size, trace and gap, drawn with a JS port of
    kicad_footprint.pixel_geometry
    - a table of every field with its value, meaning and the bits it takes (they
    add up to the payload), what follo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
2026-10-16 Design chat: no OOM spike in the narrow tail, readable errors, 4 layers, grow by default
    "Failed to fetch" on a 4-layer insole request. Most likely cause: the server was
    OOM-killed. narrow_routed_tail buffered every wire piece in the old tail as one
    MultiLineString, and GEOS needs ~300 MB for that on a dense grown board: size-9
    insole at 3.3 x 8.6 mm (29 x 28), grow mode, peak RSS 441 MB on Linux (502 MB on
    macOS) against a 512 MB instance that also runs uvicorn. Buffering each piece and
    unioning the results gives the same Edge.Cuts with +2 MB and in 0.03 s instead of
    1.4 s. Peak after the fix: 172 MB (Linux) for the same board, 2 or 4 layers.
    - main.py: JsonErrors middleware inside CORS. S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
2026-10-16 Ready-to-order designs show board previews; the Build page makes the printed case a step
    Ready-to-order designs (docs/design/examples.md, generated):
    - One card per design instead of a table row: the board's existing SVG as a
    lazy-loaded thumbnail (width/height set, fixed 4:3 white box, so nothing
    moves as images arrive; clicking opens the full SVG), then name, taxels and
    grid, pitch and readout board, and the ZIP download. Three cards per row on
    a desktop, two on a phone, so the download link is always on screen (the old
    table hid it off to the right on a phone).
    - Alt text per preview: design name, taxel count, grid.
    - scripts/make_example_designs.py --page-only rewrites just the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
2026-10-16 Readout boards: the Tag-Connect pads J2 are excluded from the position files, so JLCPCB's BOM step no longer stops on them
    J2 (TC2030 programming footprint, no part) was exclude_from_bom but still in the CPL, so JLCPCB reported 'J2 designator don't exist in the BOM file' on the 60-pin and 30-pin top boards. Footprint attribute exclude_from_pos_files added in both PCBs (kicad-cli pcb export pos no longer lists it) and the J2 row dropped from both production CPLs. tests/hardware checks every board's BOM and CPL name the same parts.
2026-10-16 Example designs carry the printed case, with tails long enough for it; the case's closed-solid check reads the exported STL
    make_example_designs adds case/ exactly as Download ZIP does, lengthening a design's cable by what the case builder asks for (+1 mm) when the case would cover the connector or find no tail, and refuses a design whose case is open. case_zip now checks watertightness on the STL bytes the user gets (one Robotiq bottom was closed in memory, open as a file).
2026-10-16 hardware: 30-pin bottom outline without its 3 nm Edge.Cuts segment (KiCad: invalid_outline); README lists every remaining DRC/ERC class and why it is accepted
    The arc now ends exactly where the next line starts. Remaining DRC errors are the board setup's generic minimums (0.5 mm via, 0.5 mm edge, 0.2 mm clearance) against values inside JLCPCB's 4-layer process (0.25 mm via, 0.2 mm edge, 0.09 mm spacing) or inside manufacturer footprints; the rule settings are not loosened. ERC: missing PWR_FLAGs, unused mux/shift channels, unwired JP3/JP4 on the 60-pin board.
2026-10-16 hardware README: the JLCPCB limits quoted hold for 2- and 4-layer boards
2026-10-16 Narrow tail: the strip sits over the pads in use, off the connector's centre, and flares each side by its own amount
    The readout boards put rows on one connector half and columns on the other, each packed against the centre, so the used pads form one block that is off-centre whenever rows and columns differ. The tail was symmetric about the connector and sized by the furthest pad, so 16 of 22 60-pin and 3 of 9 30-pin example designs kept the full tab width. fit_tail_strip now covers exactly the block (span + 2 edge, clamped to the tab) and returns its offset; make_tail_poly flares each side to the centred landing over one length set by the larger side (45 deg, half cosine). The offset is sto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
2026-10-16 KiCad export passes KiCad's own DRC: the ZIP carries board.kicad_pro with the design's rules and board.kicad_dru with the scoped exceptions
    The board's KiCad 5-style setup tokens made KiCad ignore project rules and check the flex board against rigid defaults (0.3 mm holes): 250+ errors on a correct design. Now: modern setup block; rules from the design's own parameters (trace, clearance, via, edge clearance as the generator's DRC uses); custom rules for J1's gold fingers (they reach the tab edge; JLCPCB trims them to 0.2 mm) and for the electrode gap inside a taxel. KiCad DRC: 0 errors on square, 4-layer 0.1 mm gap, fixed L-shape, UMI finger (grow and fixed), YUBI 4-layer; only silk-over-cop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
2026-10-16 Firmware: OpenTac spelling in the boot banners, prebuilt binaries rebuilt to match; firmware/README.md says what each target is, how build.sh works and that the 84% RAM warning is expected
    The two user-visible strings (the readout board's '# OpenTac single-board API'
    line and the bus controller's '# OpenTac bus v2 controller') and the comments
    said OpenTAC. firmware/build.sh --prebuilt rebuilt every target from the
    changed sources (arduino-cli 1.4.1, STM32 core 2.7.1, Teensy core 1.62.0):
    each .bin differs from the old one in exactly the two bytes 'AC' -> 'ac', the
    hex in its two data digits and the record checksum. SHA256SUMS updated; the
    unchanged sources had first rebuilt byte-for-byte to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
2026-10-16 Examples: the board scripts print one line saying what is missing instead of a traceback; examples/README.md lists each script, whether it needs a board, and its command
    read_sensor.py, record_take.py and xampling.py run in main() and catch
    DeviceError (and Ctrl-C) at the top, so with no board, no skin or no answer
    they exit with 'error: <reason>', the reason naming the next step.
    record_take.py now checks for the manifest like read_sensor.py does.
2026-10-16 Device tooling first run: a blank board gets BOOT0 instructions, Linux permission errors are named, only ST/Teensy ports are probed, 60pin/30pin board names, prebuilt firmware in the wheel, CLI and A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
    - flash: no board answering and none in DFU -> say a new board has no
    firmware, hold BOOT0 while plugging in, then flash --board readout60 / node16.
    A board in DFU with no --board -> ask for --board. --dry-run --board X prints
    the command with no board attached (and without a flashing tool). The
    missing-tool error names brew / apt / STM32CubeProgrammer.
    - Linux: ports that refuse to open are collected; 'found /dev/ttyACM0 but cannot
    open it (permission denied): sudo usermod -a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
2026-10-16 Published pages and CITATION.cff carry no TODO/CHECK comments (they reached the public HTML); the paper page drops its arXiv button, which linked to "#"; the home page says OpenTac-Sim is for flat sk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
2026-10-16 Tests: no path into the owner's OneDrive; four lab manifests and the original tool's bytes for them are fixtures that run everywhere, the full 30-manifest sweep runs when OPENTAC_STM_TEST is set; CI 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
    The four manifests (robotiq_long, old, new, 32x32_HD) are OpenTac-CAD exports, not the JHU exo boards. Golden bytes from stm_test/tactile_imu_fast_cfg/opentac_device.py.
2026-10-16 README: script a design (insole example, 200 taxels in about 5 s; main.generate from your own script), simulate without a board, run the tests; shallow clone, the Linux launcher command, the Teensy 4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
    Every README snippet was run on a fresh environment with no extras (and with sim/demo). Issues link the docs, not Discussions: Discussions are off for the repository.
2026-10-16 README: the insole example is 10 columns x 28 rows (the manifest's count; the old report counted routed segments), and a scripted design prints no [chat] line on main
    Checked against main at 2e03f9d: insole 200 taxels, 10 x 28, DRC clean; the square script prints "88 taxels, 0 DRC violations".
2026-10-16 Phone load: clip stills below the first screen load only near the screen (data-poster), clips and stills start after the load event, the hero has 800/1400/2200 px versions with fetchpriority, and the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
    Browsers fetch every poster at page load whatever preload says, so the home page pulled 2.9 MB before the hero finished (12.7 s LCP on a throttled phone). opentac.js now sets data-poster when a clip comes within 1.5 screens, and starts both observers after window load so nothing competes with the hero. readout60/30_poster.jpg are the spin loops' first frames; make_board_media.py now writes them. The PNG renders stay for the hardw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
2026-10-16 Tail length is automatic by default: long enough for the narrow tail and for the printed case to clear the connector
    A 12 mm tail was too short twice over: most 60-pin narrow tails could not flare back to the connector in it (9-22 mm needed), and with Download ZIP always adding the printed case, the case covered the connector body or left it no flex on 26 of the 31 example designs (2-layer grow). cable_length_mm is now optional: omitted, the board is laid out and routed with the 12 mm minimum, then the tail is made as long as it needs to be (pipeline/tail_length.py), rounded up to 0.5 mm: (a) the narrow tail's flare at 45 deg plus MIN_STRAIGHT_MM, known from the pads before anything is built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
2026-10-16 KiCad rules: a taxel's electrodes are min(gap, center_clear) apart
    The finger tips stop center_clear short of the other electrode's spine and the
    row via, so on designs whose electrode gap is wider than the 0.2 mm centre
    clearance (the calibration set's gap 0.3-0.5 designs) the exported
    board.kicad_dru's 'Taxel electrode gap' rule flagged every tip: about 500
    clearance errors per board in KiCad. The rule and the board's min_clearance now
    use min(gap_mm, center_clear_mm). New DRC test case with a 0.4 mm gap.
2026-10-16 Site: a picture for every text-only stretch on the design, build and use pages
    Audited every page at 1440 px for a screen or more of text with no image,
    clip, table or diagram, and gave each a visual drawn from the real thing:
    - OpenTac-CAD screenshots (start screen, robot gallery, a generated board,
    the three case lids, an STL surface picked and unfolded, the download bar)
    from scripts/make_doc_screens.cjs, which drives the current tool;
    - figures generated from the repository by scripts/make_doc_figures.py:
    board previews from the compiler (grow/fixed/4-layer, an annotated example,
    the skill's insole), the live viewer's drawing of a recorded press, a take,
    frame.taxels vs frame.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
2026-10-16 Site visuals follow-up: board pictures with the automatic tail, gain context, readout profiles
    - Regenerated every figure and OpenTac-CAD screenshot that shows a board or
    the result panel on the code with the automatic tail length:
    design_settings.svg (the Tail label now gives the 22 mm automatic length),
    design_modes.svg (panels now aligned on the drawn shape, since the tails
    differ), agent_insole.svg, cad_generated.webp (shows the Tail length row),
    cad_download_bar.webp. Taxel counts are unchanged (144/63/83, 122, 200, 81);
    the case lids, QR back, sim and viewer figures came out the same.
    - Simulate: the readout-profile plot is back, with where each profile reaches
    the ADC ma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
2026-10-16 Readout boards: the feature list shows what it says. A clip each for the zero-potential readout (a 4 x 4 grid scanned with the other rows open, then held at 0 V; currents solved per step), the IMU (a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
2026-10-16 Readout boards: the IMU clip shows vibration and orientation large, the daisy chain shows the plugs going in, and USB gets a picture
    IMU: the board fills the left half, turned by its quaternion; on the right the angle turned and the vibration (each accelerometer axis high-passed at 8 Hz, then the magnitude, in g) on one time axis, the tactile frame across the bottom. Daisy chain: close up, the JST-SH plugs go into the boards' sockets, then the view pulls back to the chain and the Teensy; the opentac view window comes in only once the USB cable is in; posters are representative frames. USB: a still of both boards with a micro-USB cable plugged in (both boards have micro-B receptacles). Text: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
2026-10-16 Manifest edge_cuts: keep the corner at the connector's open edge
    The board's Edge.Cuts walk is open at the connector (the opening segment is
    dropped where the footprint continues), and the manifest emitted only each
    segment's start, so it lost the corner at the end of the tail's side and the
    ring closed with a diagonal chord across the tail. edge_cuts now keeps that
    corner and closes straight across the opening. The back silk (QR placement,
    5 mm grid, dimension label) follows the corrected ring: the grid now fills the
    tail up to the connector.
    The two 60-pin example manifests get the missing corner (their READOUT60
    config fixtures' config_id and trailing crc recomputed, the only bytes that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
2026-10-16 Narrow tail: a quick square step out to the connector's tab instead of the long flare; a diagonal tail extension is DRC-clean; Redo padding applies a typed Tail length
    The tail cut to its wires runs straight into the tab, each side turning out
    square through a 1 mm fillet (connector_shoulder_fillet_mm) and a 0.5 mm
    rounded corner, 1.5 mm long, as on the boards fabricated before; a smaller
    step keeps the fillet as an S, a flush side runs straight on. Every tail of
    the 12 mm minimum narrows fully, so the automatic length is set by the printed
    case alone. A typed tail width keeps the flare it is routed with, and so do
    tails narrowed by designs saved before.
    A drawn extension's wire lanes carry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
2026-10-16 Skill: name the real Redo padding call (opentac.cad.main.redo_padding with the held edit_data and its routes)
2026-10-16 Tail extension: a direction that would put the extension or its turned connector on the board is greyed out
    A path that turns too early lands the connector (turned with the path, 30.5 mm
    long on the 60-pin board) on the board's own padding and the wiring round its
    corner, and the export shorts them; no routing can make it work. Each
    direction button (and Add segment, Apply) is now disabled when its segment
    would make the extension's outline overlap the board's, outside the tail it
    replaces, by more than 0.5 mm, and the panel says to run the tail further out
    first (tail-guard.js).
    Checked against KiCad DRC on the 31 example designs x 2/4 layers x
    grow/fixed x five directions at 20 mm: all 39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
2026-10-17 OpenTac-CAD UI: plain start screen, taxel wording, server wake notice, fewer re-exports
    Start screen: headings, card and example blurbs rewritten as short factual
    text (what each option does, what an example gives you). Every feature and
    link kept; "feet" dropped from the robot gallery text, which has none.
    Wording: "taxel" throughout the UI instead of "pixel" / "sensing spot" /
    "sensor" for one sensing element, with a one-line definition in the start
    screen glossary, the Parameters panel and the help glossary. The
    piezoresistive layer is no longer called Velostat: buttons read "Layer DXF"
    and "Layer fold PDF", tooltips name the material ("e.g. Velostat,
    LINQSTAT"). Element ids, API fields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
2026-10-17 OpenTac-CAD: 'Piezo layer DXF' / 'Piezo layer fold PDF' (a bare 'Layer' read like a PCB copper layer)
2026-10-17 Pages: stamp the CAD tool's own files with the release version
    Right after a deploy a browser could combine the new app.js with an older
    cached design-name.js (Pages caches files for 10 minutes); the new code imports
    zipName, which the old module lacks, so the whole tool failed to start and
    Generate did nothing. Every reference to the tool's own scripts, stylesheet and
    example list now carries ?v=<commit>, so a page load never mixes two releases.
2026-10-17 OpenTac-CAD: a blocked server check no longer stops Generate
    The wake notice added today made Generate and Download wait until /health
    answered. Ad and privacy blockers cancel requests to .../health
    (net::ERR_BLOCKED_BY_CLIENT), so in such a browser Generate waited forever.
    A probe that fails at once twice is now taken as blocked: the page stops
    waiting on it, shows 'Server: status unknown', and requests go straight out as
    before. A sleeping server holds the request open instead, so it still gets the
    wake notice. Checked against the live server with /health blocked (Generate
    finishes) and unblocked (unchanged).
2026-10-17 OpenTac-CAD: keep the cable tail to the connector's tab; check the exported Edge.Cuts
    Grow-mode boards with 14 or more rows or columns on the 30-pin board (29 or more
    on the 60-pin) exported slits beside the connector tab. Their outermost wires
    run 0.5 or 1.0 mm from a tab side, inside route_containment_mm (1.05 mm). The
    export pass re-runs post-route containment after its synthetic tail extension
    (main._outputs_with_connector_tail), and it padded those wires too: the tail
    grew past the tab (to +-15.8 mm on a 60-pin tab of +-15.25) from the board down
    to the pad drills. The connector footprint's tab-side Edge.Cuts then lay inside
    the board, 0.02 mm from the board's own cut (60-pin full width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
2026-10-17 OpenTac-CAD: clip the board to the connector's tab past its opening
    The Edge.Cuts check (f754815) still found slits beside the connector's tab on
    three paths, all of them already broken before it:
    - a typed Tail width wider than the tab (a field on the page): the tail
    rectangle ran on past the connector's opening beside the tab;
    - a bigger-connector swap (connector_pos_override): _close_connector_shoulders
    padded the shoulder trace_w/2 + board_edge_clear_mm past the new tab, for
    wires it took to land at the tab edge (they keep their pads, a pad pitch or
    more inside the old tab). On fixed outlines its fillet wedge also met the
    cable along a zero-width seam: a 1 mm slit;
    - follow pa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
2026-10-17 README: current clone sizes
2026-10-19 Pin integration checks to the verified website-only revision
2026-10-19 Point CAD code downloads to the separate code repository
2026-10-20 Coverlay openings JLCPCB's flex process can make
    The solder mask on a flex board is a polyimide coverlay, and JLCPCB needs at
    least 0.3 mm of film between two openings. Per-pad openings left 0.2 mm
    between a taxel's electrode fingers and between the connector's gold
    fingers, and opened every row via on both sides.
    - Top: one opening per taxel over its electrodes and via, the electrode
    copper plus min(0.075, (copper gap - 0.3) / 2) per axis, checked against
    the real placements (export/coverlay.py). On a dense board the opening is
    trimmed into the electrodes and stats["mask_note"] says so; the result
    panel shows it. Wiring between taxels stays covered.
    - Bottom: one opening across the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
2026-10-20 Built-in Gerber writer: plot the board, not its mirror image
    The pure-Python Gerber and drill writer (used whenever kicad-cli is missing,
    so for every export from the hosted service) negated Y on every coordinate it
    wrote. KiCad's board space is Y down: kicad_pcb.py negates Y on the way in and
    KiCad's plotter negates it back on the way out, so a KiCad Gerber carries the
    board frame unchanged. Negating a second time in gerber.py and excellon.py
    mirrored every layer and the drill file, and a board ordered from the hosted
    files came out as the mirror image of the design.
    - gerber.py: all coordinates now go through one writer, _xy(), in the board
    frame. _draw_line, _flash and the region write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
2026-10-21 Example designs footnote without the 70-pin board; questions go to GitHub Discussions [skip render]
2026-10-21 Simulation: the bump model's core is Jiafeng Gu's TactileSim lumped model [skip render]
    opentac.sim.mujoco runs on TactileSim's BumpParams, loader, surrogate and frustum bump body:
    manifest and parameter checks, a force solve that brackets its root and refuses unreachable
    or over-compressing loads, no contact beyond an object's radius, a least-squares moment split,
    and load-conserving wrench distribution. Every scene builds its bumps as full-precision
    frustums. The API, the 15 MPa default and the lying cylinder are unchanged; footprints may
    touch within 0.01 mm. The readout checks its inputs. The changed files are Apache-2.0 (NOTICE).
2026-10-21 OpenTac-CAD: remove unused definitions [skip render]
    Nothing in this repository or the website repository references them:
    pipeline/route_astar.py; kicad_pcb._build_connector; seven Gerber helpers
    (_append_new_aperture_defs, _connector_pad_bbox, _pad_axes,
    _is_axis_aligned_pad, _flash_rect, _draw_stroked_pad, _local_to_world); the
    geometry.py connector-ear, trim, resolve_tail_width and
    apply_cable_transform_dir helpers; mesh_unroll.uv_to_outline_array,
    inner_hug._component, layout.net_counts, print_pdf fill_color and ALERT,
    inner_engine.TOL, sim_pack.SIM_README; face-select.js extractFlatFace and
    views.js currentView. The connector_geometry docstrings now state the
    convention and the pad re-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
2026-10-21 OpenTac-CAD: remove developer tools, log chat at DEBUG, fix stale tests [skip render]
    - Remove the example-curation tools: /dev/capture-example (ExampleAnnotation,
    ANNOTATIONS_DIR), /example-stls and /example-stl, the example STL picker and
    "Save as example" button, window.otcGetOutlineState, and the window hooks
    __otc_debug, __otcLoadForThumb and otcReplayAnnotationHighlight. Only these
    tools used them; the landing gallery loads web/example-meshes/.
    - Chat: prompts, replies, tool calls and usage go to the logging module at
    DEBUG instead of being printed; the route registration logs at INFO.
    - main.py: one __main__ block, after the chat router and the frontend mount;
    CORS allows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
2026-10-21 OpenTac-CAD browser test: read the taxel count from the current stats label [skip render]
2026-10-21 Scripts: state where the website-asset scripts write, correct the doc-figure data claim, remove the if-False expressions [skip render]
    make_doc_figures.py: the view, take and frame_image figures read recorded data from the website repository, not from this one; the two 'x if False else y' expressions become 'y', and the __import__ calls become ordinary imports. The figures drawn are unchanged.
2026-10-21 Examples and hardware docs: website links and images, no stale BOM note or test-status sentence [skip render]
    The board images and flash and simulation references point to opentac.github.io. The 30-pin bottom BOM already lists 0402 parts (C1525, C52923, C11702), so the note about wrong package sizes is removed. SOURCES.md no longer says that added UMI meshes take precedence, which no code does.
2026-10-21 Repository files: CONTRIBUTING test table and render.yaml comment in the present tense; no ignore rules for the former docs folder [skip render]
    The .dockerignore 'docs' rule matched nothing: the Dockerfile copies only pyproject.toml, uv.lock, README.md, opentac/, .claude/skills/, examples/stl/ and firmware/prebuilt/, so the image contents are unchanged.
2026-10-21 Firmware: comments state each rule inline, without retired sketch names, dated notes or history [skip render]
    Comments only: no code, string, macro or build logic changes. Every target built from these sources is byte-identical to firmware/prebuilt (SHA256SUMS). The hardware description now distinguishes the 30-pin board's two shift registers and 16:1 mux, the parameter table count is 21 on the 60-pin board, and the bus host test's build line and Python test path are corrected. library.properties gets an author, maintainer and URL; build.sh points to the website's flashing page.
2026-10-21 OpenTac-CAD: rewrite comments as present-tense explanations [skip render]
    Comments and docstrings only; no code changes (checked by comparing the AST
    with docstrings removed, and JS/CSS/HTML with comments removed).
    - Remove development history, measurement anecdotes, process notes, private
    repository names, internal documents that are not in this repository, and
    old backend/ and frontend/ paths; state each rule and its reason instead.
    - Correct comments that contradicted the code: the default router, the hug
    plan and emission phases, the default 4-layer wire model and pad exit, the
    Gerber connector-pad regions, the removed anchor-hole feature, the optional
    sim3d block, nonexistent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
2026-10-21 OpenTac-CAD route editor: use the ellipsis character in status messages [skip render]
2026-10-21 Library text: website links, present tense, no internal references [skip render]
    - User-visible messages and docstrings that pointed at docs/*.md now give the
    website pages (use/flash, use/flash#on-linux, use/daisy-chain, use/sensor,
    reference/protocol, hardware, sim), each checked to resolve.
    - sim/mujoco: comments and docstrings state the model in present tense,
    without references to research notes, stage numbers or measurements from
    earlier iterations; the two solref comments of the lattice scene are merged
    into one consistent comment. Generated MJCF is identical apart from XML
    comments. scene.py, grip.py and lattice.py are described as part of the
    OpenTac bump model (none c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
2026-10-21 Readout boards and tests: 60-pin board hardware-checked, no lab-only tests [skip render]
    - readout60.json: hardware_checked is true and the note that the wiring was
    not yet confirmed is removed, so setup() no longer warns for the 60-pin
    board. The warning remains for any board that sets hardware_checked false;
    a new test covers that path with a patched board table.
    - Board sources point to hardware/readout_60pin/readout_60pin.kicad_pcb and
    hardware/readout_30pin/bottom/readout_30pin_bottom.kicad_pcb (their
    connector nets match the pad tables); the 70-pin board is described as not
    in this repository.
    - Removed the two tests that always skipped outside the lab (they needed a
    priv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
2026-10-21 CAD tests: present-tense docstrings, no runners or debug prints [skip render]
    - Docstrings and comments state the property each test guards instead of the
    history of the bug, without quoted reports, names or internal documents;
    comments that contradicted the code (odd line counts, removed anchor
    cutouts) are corrected.
    - Removed the __main__ runners, the OK/PASSED prints and the unused imports
    and locals; renamed tests whose names said "still", "actually" or
    "regression".
    - test_pipeline_e2e: the connector folder resolves to opentac/cad/connectors
    (it pointed at a folder that does not exist, so the board was exported
    without its connector), the DRC result is asserted to be clea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
2026-10-21 Hardware libraries: 3D model paths relative to the project, like the boards [skip render]
2026-10-21 Example manifests and test fixtures: neutral library names and OpenTac-CAD wording; reference configs updated for the new manifest ids [skip render]
2026-10-21 PCB Preview: the SVG fills the panel, so a zoomed view uses the full panel width [skip render]
    The SVG element took its proportions from the board, so for a tall board
    it was a narrow column in the middle of the panel, and zooming (which
    changes only the viewBox) showed the zoomed board inside that column.
    The element now fills the panel and the default preserveAspectRatio fits
    the board inside it; the fitted view is unchanged. Panning converts
    pixels to viewBox units with the fitted scale, which is the same on both
    axes.
2026-10-23 Replay: play a recorded take in the heatmap viewer
    A take folder from record or view --save opens with no board attached:
    opentac replay TAKE, with --snapshot for a PNG of one frame.
